Ratikantamishranordhausen/MectoSYS/09_Images/WhatsApp Image 2026-07-16 at 11.11.07 PM (3).jpeg

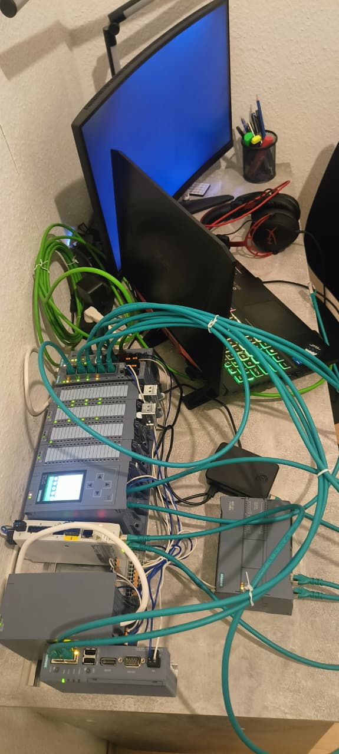
09_Images/WhatsApp Image 2026-07-16 at 11.11.07 PM (3).jpeg
