Ratikantamishranordhausen/MectoSYS/README.md

# MectoSYS
Secure Industry 4.0 OT/IT integration platform featuring real-time machine control, motion automation, industrial networking, edge computing, cloud connectivity, production data acquisition, cybersecurity, and remote maintenance.
