Ratikantamishranordhausen/MectoSYS/MectoSYS proto design.pdf

## MECTOSYS

### Machine Name

: MECTOSYS Prototype for software development, testing, validation and demo.

### Total Power Feed

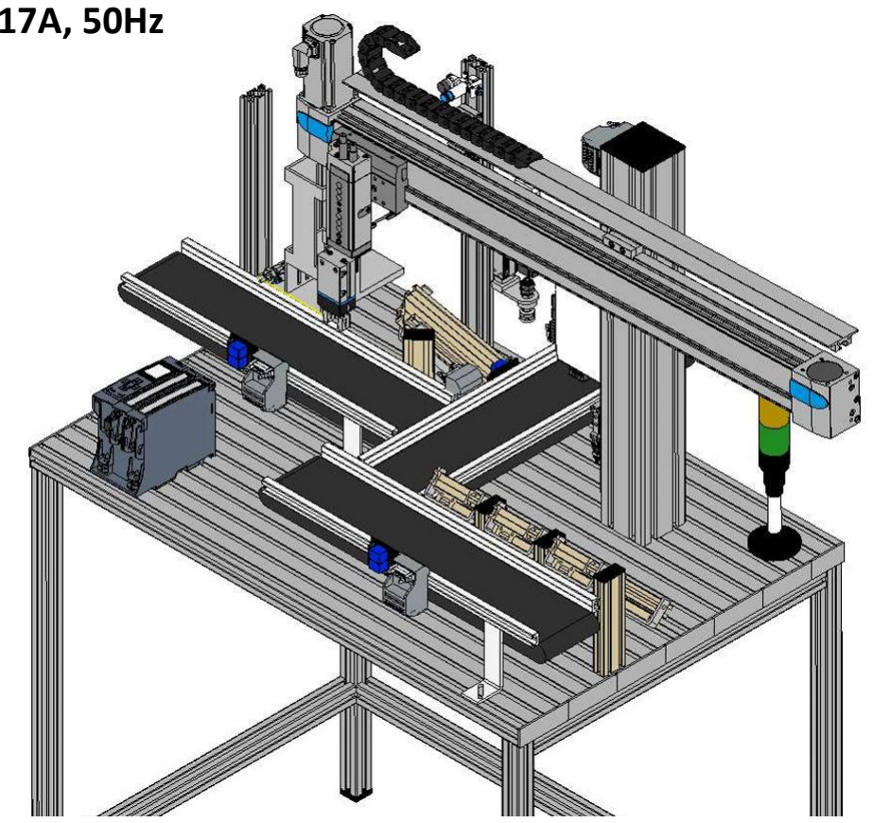
[picture p3: figure]

: | 1Φ, 4KVA, 230V AC, 17A, 50Hz

### Control Voltage

### : 24VDC Valve Voltage

### : 24VDC Voltage for Lamp

### : 24VDC

Volt.

### for Inputs

### : 24VDC Volt. for

### Output

### : 24VDC Drives

### : FESTO Make Drive Control

### : FESTO MAKE PLC

### : Siemens 1500/ 1200

## MECTOSYS

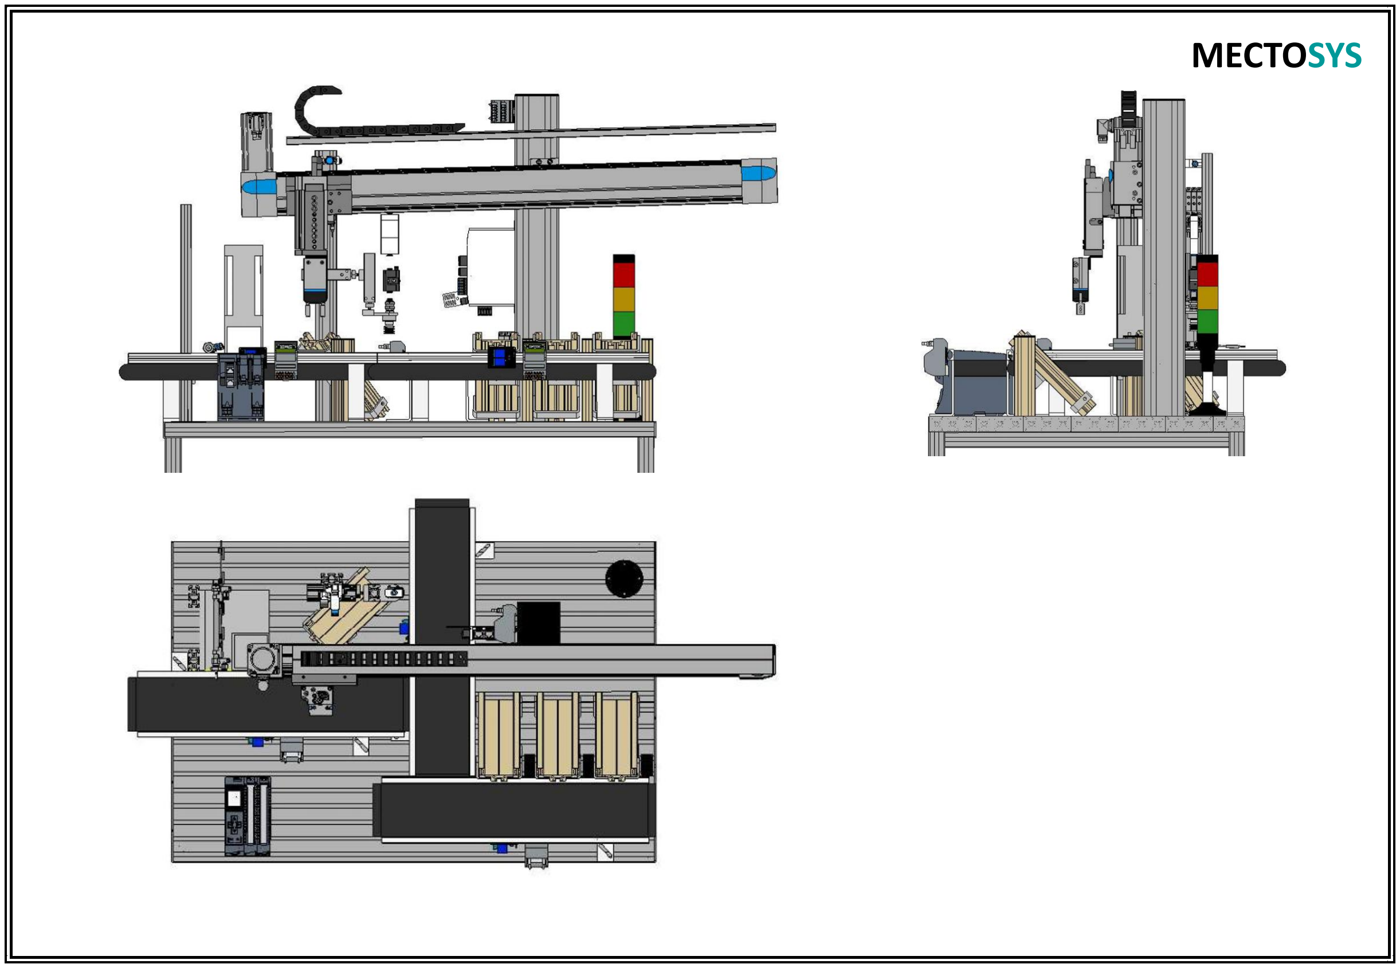
[picture p4: page 2]

### General Safety Instructions

- All installation, commissioning, and maintenance work must be carried out only by qualified and authorized personnel in accordance with applicable electrical standards and regulations.
- Before performing any work on the system, ensure that the power supply is completely disconnected and secured against accidental reconnection.
- Verify that all components are properly grounded and that protective earth connections are correctly installed.
- Use appropriate personal protective equipment (PPE) such as insulated gloves, safety shoes, and eye protection when working on electrical systems.
- Ensure that the supply voltage, frequency, and environmental conditions match the specifications of the installed devices.
- Do not exceed the rated current, voltage, or load capacity of any component to prevent overheating, damage, or fire hazards.
- Use correctly rated circuit protection devices (MCB, fuse, etc.) and ensure proper selection based on load characteristics.
- Avoid contact with live parts. Always assume that terminals are energized unless verified otherwise using appropriate measuring instruments.
- Ensure proper cable sizing, insulation, and routing to avoid mechanical damage, short circuits, or overheating.
- Maintain adequate ventilation around power supplies and electrical components to prevent overheating.
- Keep the work area clean and free from moisture, dust, and flammable materials.
- Do not modify or tamper with equipment unless explicitly permitted by the manufacturer.
- In case of abnormal operation (noise, smell, overheating), immediately disconnect the power supply and investigate the issue.
- Follow all manufacturer-specific guidelines for devices such as Siemens and FESTO components.
- Ensure emergency stop and isolation mechanisms are accessible and functioning correctly.

# PNEUMATIC CIRCUIT MECTOSYS

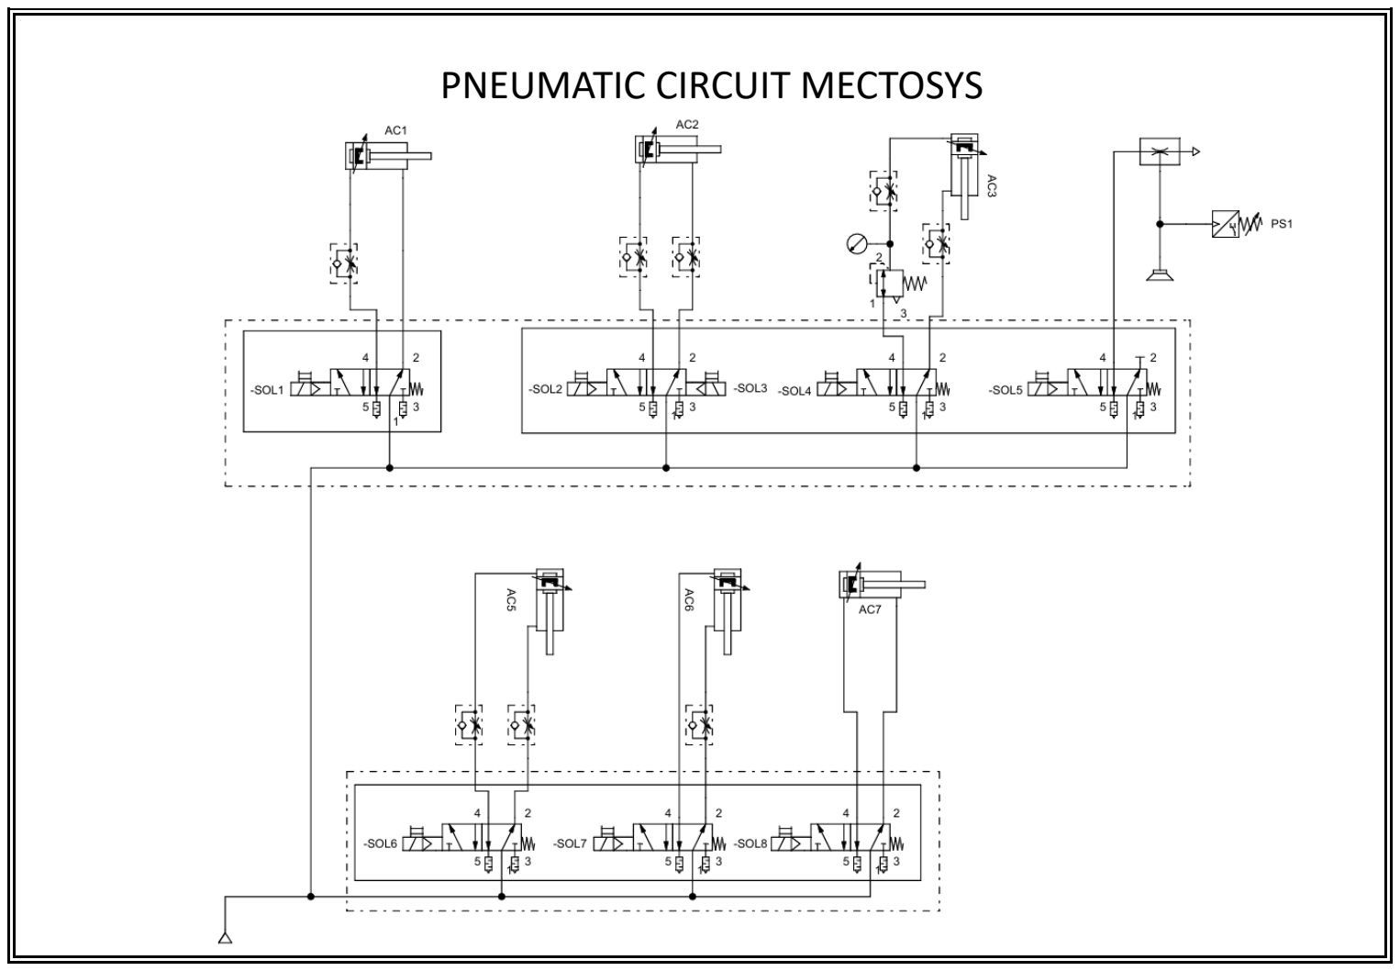
[picture p5: page 4]

X1
X4

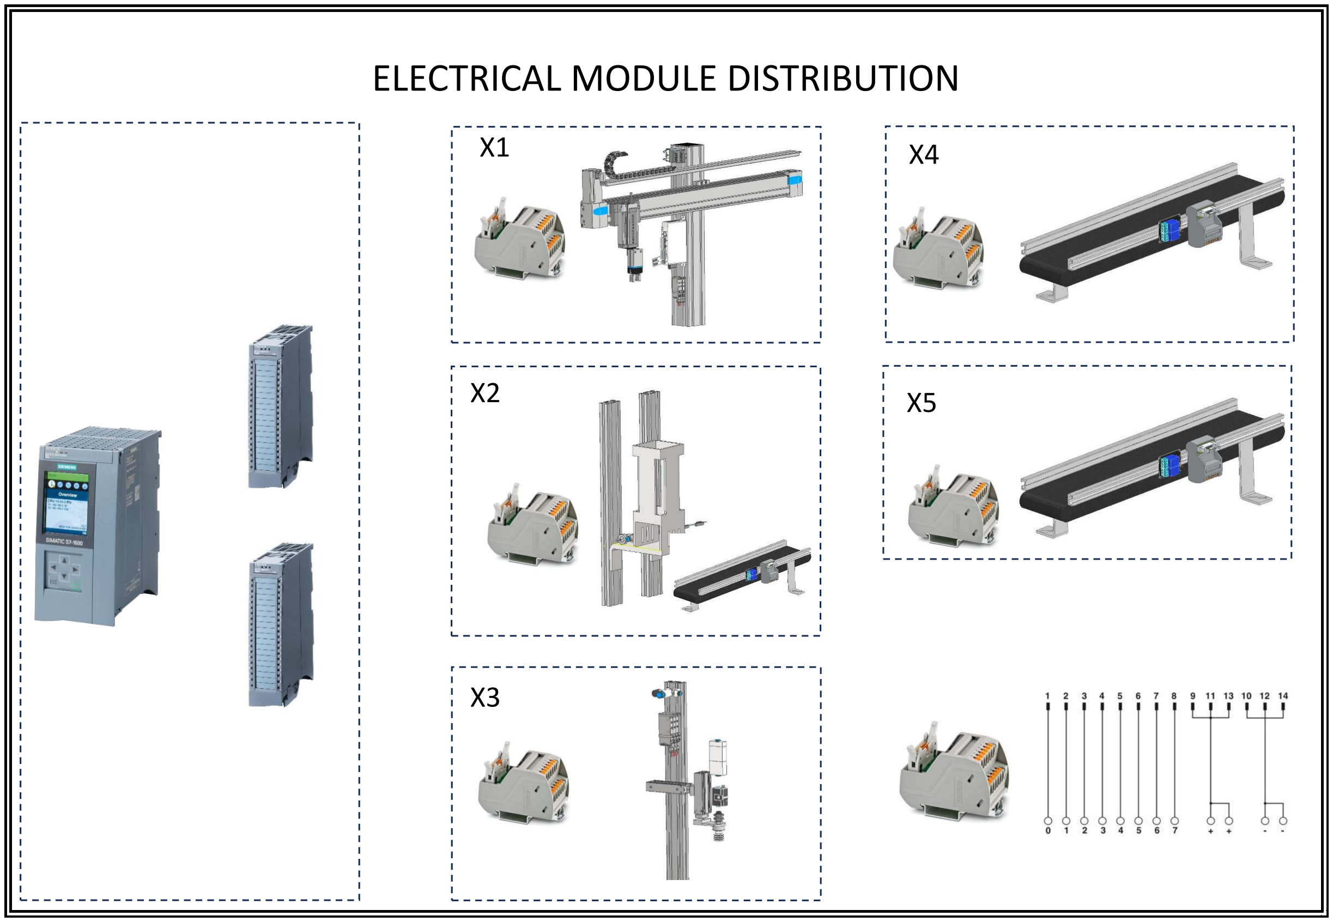
[picture p6: page 5]

X2

X3

X5

# ELECTRICAL MODULE DISTRIBUTION

OT Network Architecture OT Network Architecture (IT Network Confidential) (IT Network Confidential)

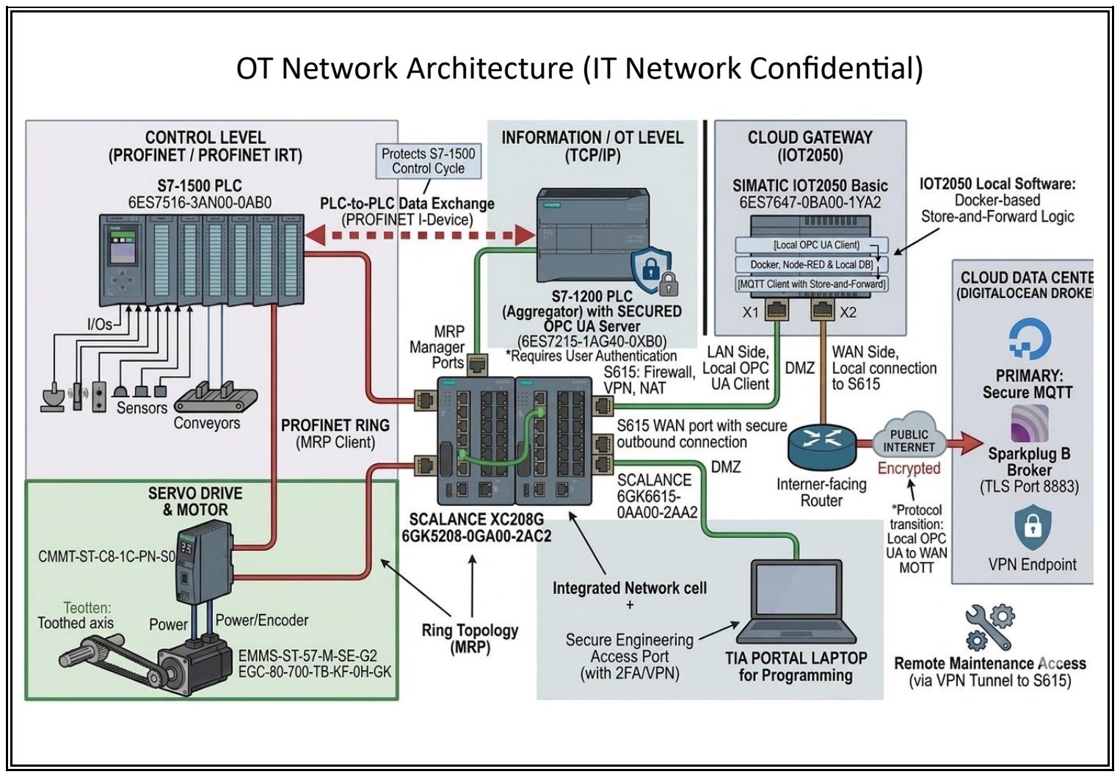
[picture p7: page 6]
