Ratikantamishranordhausen/MectoSYS/01_Mechanical_Design/01_CAD Design/PDF/conveyor.pdf

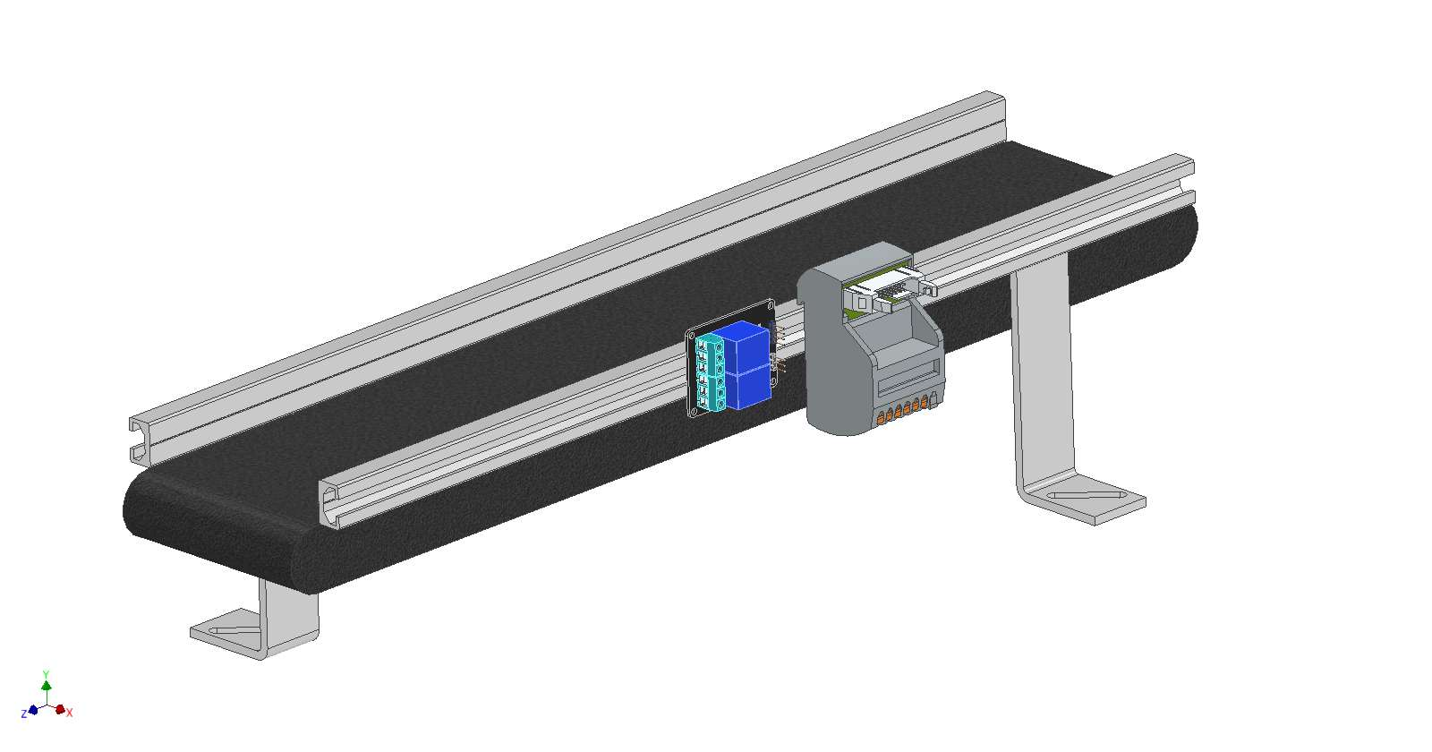
[picture p8: figure]
