Ratikantamishranordhausen/MectoSYS/01_Mechanical_Design/01_CAD Design/PDF/Distribution Module.pdf

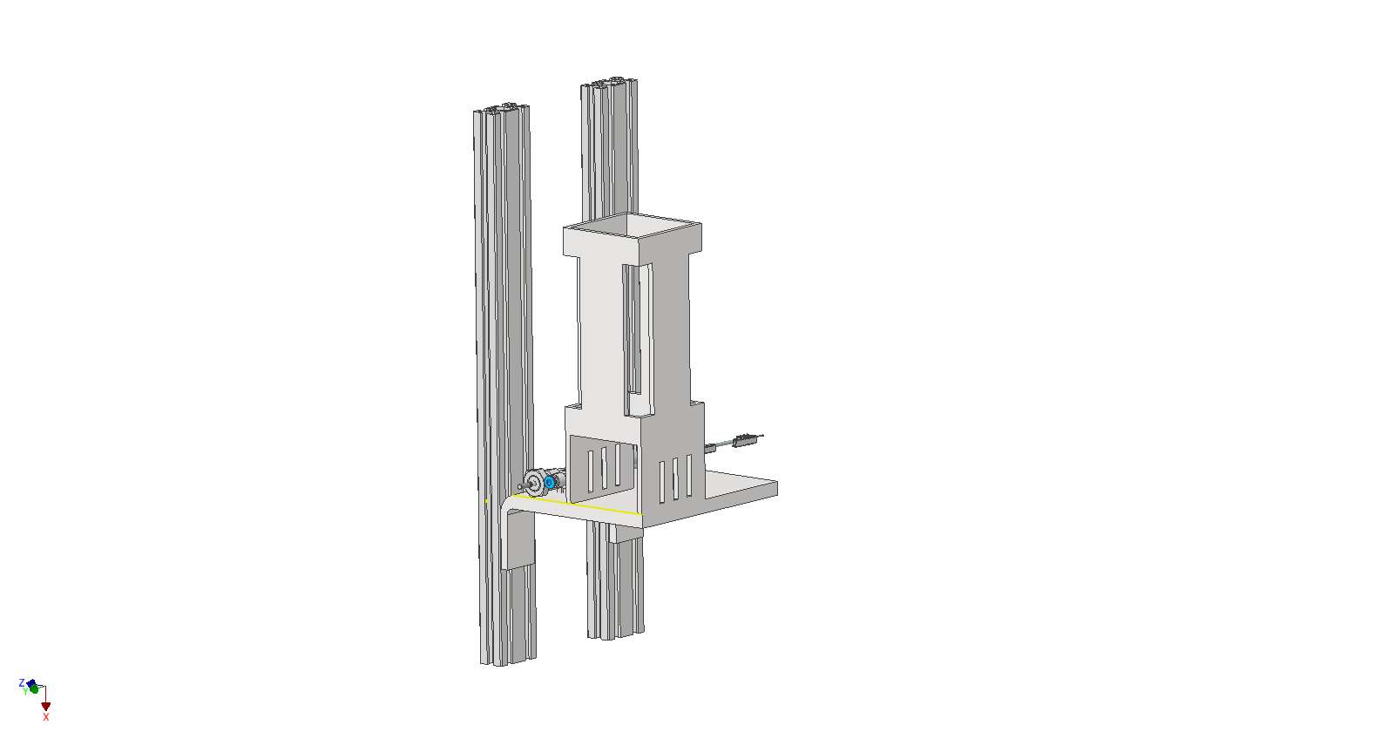
[picture p9: figure]
