Ratikantamishranordhausen/MectoSYS/01_Mechanical_Design/01_CAD Design/PDF/Handelling.pdf

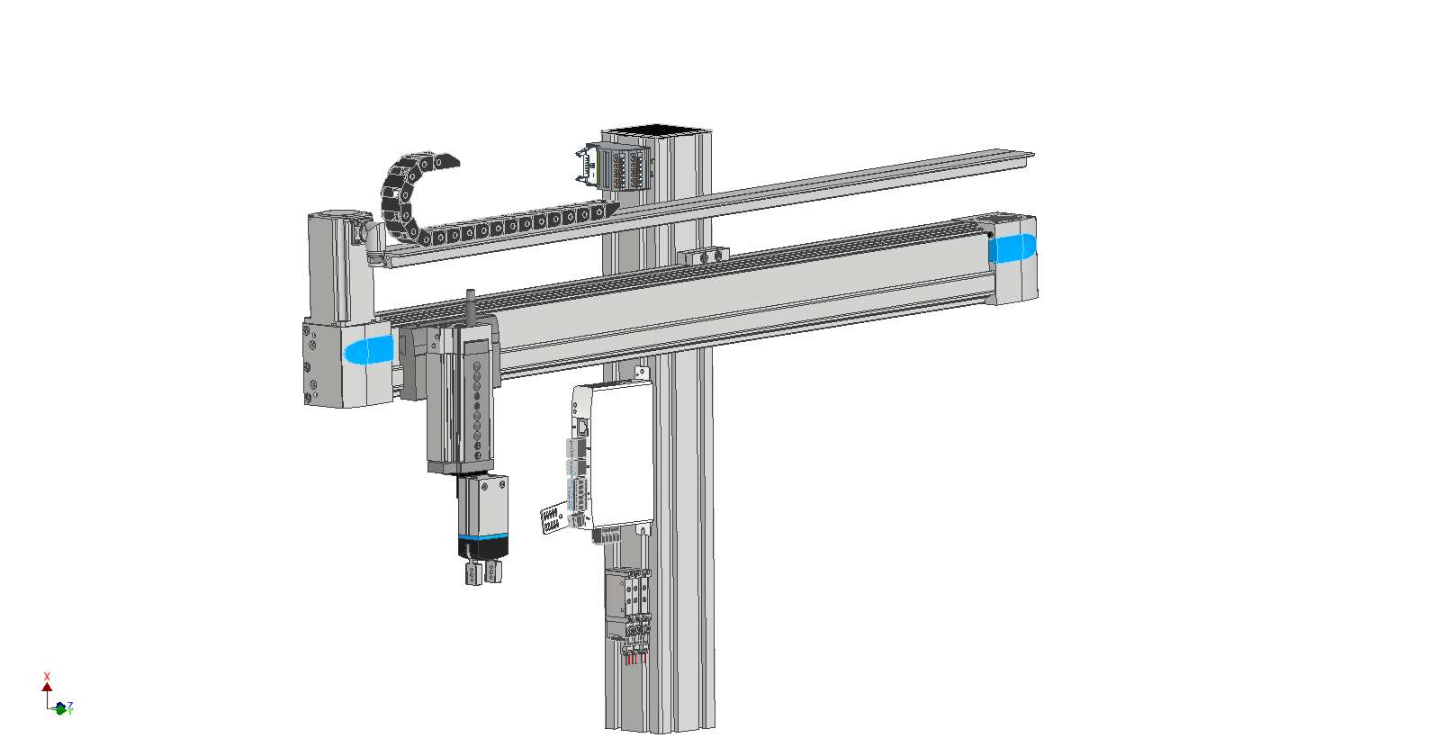
[picture p10: figure]
