Ratikantamishranordhausen/MectoSYS/01_Mechanical_Design/MectoSYS_Proto_BOM_Rev6.xlsx

Sr No | Component Name | Component Details | Part No | Criticality | Material Status | Remark | Supplier 1 |  |  |  |  |  |  |  | Supplier 2 |  |  |  |  |  |  |  | Supplier 3 |  |  |  |  |  |  |  | Supplier 4 |  |  |  |  |  |  |  | Lead Time (Days) | Specification
 |  |  |  |  |  |  | Supplier Name | Condition | Link | Price | Tax | Qty (Nos) | Total Price | Total Price | Supplier Name | Condition | Link | Price | Tax | Qty (Nos) | Total Price | Total Price | Supplier Name | Condition | Link | Price | Tax | Qty (Nos) | Total Price | Total Price | Supplier Name | Condition | Link | Price | Tax | Qty (Nos) | Total Price | Total Price
1 | Sick WTB4-3P2161 1028099 Photoelectric Sensor | Sensor | WTB4-3P2161 1028099 |  | Received |  | IndustryMall | Used | Link (https://industrymall.de/en/sensors/28370-sick-wtb4-3p2161-1028099-photoelectric-sensor.html) | 10.71 | 12.75 | 8 | 85.68 | 102.00 | Wiautomation | New | Link (https://de.wiautomation.com/sick/general-automation/sensors/WTB43P2161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) |  | 206 | 8 | 0 | 1648.00 | RS Components | New | Link (https://de.rs-online.com/web/p/optische-naherungsschalter/2409366?matchtype=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) |  | 212.74 | 8 |  | 1701.92
2 | Festo EMMS-ST-57-M-SE-G2 1370479 | Motor | EMMS-ST-57-M-SE-G2 1370479 | High | Received -OK |  | IndustryMall | Used | Link (https://industrymall.de/en/servo-engines/26403-festo-emms-st-57-m-se-g2-1370479.html) | 67.86 | 80.75 | 1 | 67.86 | 80.75 | RS Components | New | Link (https://de.rs-online.com/web/p/schrittmotoren/1816687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) | 427.96 | 509.27 | 1 | 427.96 | 509.27 | Landfeld | New | Link (https://www.landefeld.de/artikel/de/emms-st-57-m-se-g2-1370479-schrittmotor/OT-FESTO034681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) |  | 509.27 | 1 |  | 509.27 | Wiautomation | New | Link (https://de.wiautomation.com/festo/drives-motors-circuits-protection/1370479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) |  | 380 | 1 |  | 380
3 | Festo 8084004 CMMT-ST-C8-1C-PN-S0 Servo | Drive | CMMT-ST-C8-1C-PN-S0 8084004 | High | Received -OK |  | IndustryMall | Used | Link (https://industrymall.de/en/plc/26331-festo-8084004-cmmt-st-c8-1c-pn-s0-servo.html) | 125 | 148.75 | 1 | 125 | 148.75 | RS Components | New | Link (https://de.rs-online.com/web/p/motorsteuerungen/0193554?matchtype=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) | 466.20 | 554.78 | 1 | 466.2 | 554.78 | Landfeld | New | Link (https://www.landefeld.de/artikel/de/cmmt-st-c8-1c-pn-s0-8084004-servoantriebsregler/OT-FESTO085049) |  | 462.32 | 1 |  | 462.32 | Wiautomation | New | Link (https://de.wiautomation.com/festo/drives-motors-circuits-protection/8084004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) |  | 465 | 1 |  | 465
4 | Festo NEBM-M12W8-E-2.5-LE8 1451675 Encoder Cable New | Encoder cable | NEBM-M12W8-E-2.5-LE8 | HIgh | Received -OK |  | IndustryMall | Used | Link (https://industrymall.de/en/plc/29236-festo-nebm-m12w8-e-25-le8-1451675-encoder-cable-neu.html) | 25 | 29.75 | 1 | 25 | 29.75 | RS Components | New | Link (https://de.rs-online.com/web/p/sensor-und-aktor-kabel/2739632?searchId=2e5fe6e2-d660-4d90-86c9-56a42a7b367a) | 68.48 | 81.49 | 1 | 68.48 | 81.49 | Landfeld | New | Link (https://www.landefeld.de/artikel/de/nebm-m12w8-e-2-5-le8-1451675-encoderleitung/OT-FESTO035117) |  | 67.91 | 1 |  | 67.91 | Wiautomation | New | Link (https://de.wiautomation.com/festo/general-automation/1451675-festo-nebm-m12w8-e-2-5-le8) |  | 75.33 | 1 |  | 75.33
5 | Festo NEBM-S1W9-E-7-Q5-LE6 1450739 Motor cable | Motor cable | NEBM-S1W9-E-7-Q5-LE6 | High | Received -OK |  | IndustryMall | Used | Link (https://industrymall.de/en/plc/26931-festo-nebm-s1w9-e-7-q5-le6-1450739-motor-cable.html) | 17.86 | 21.25 | 1 | 17.86 | 21.25 | RS Components | New | Link (https://de.rs-online.com/web/p/motorzubehor/2739659?searchId=1fb4da12-3dd8-4de6-bb85-0255028b82dd) | 109.85 | 130.72 | 1 | 109.85 | 130.72 | Landfeld | New | Link (https://www.landefeld.de/artikel/de/nebm-s1w9-e-7-q5-le6-1450739-motorleitung/OT-FESTO035132) |  | 108.93 | 1 |  | 108.93 | Wiautomation | New | Link (https://de.wiautomation.com/festo/general-automation/1450945-festo-nebm-s1w15-e-5-q7-le6) |  | 99 | 1 |  | 99
6 | Festo EGC-80-700-TB-KF-0H-GK 556814 Toothed Belt Axis | Toothed Belt Axis | EGC-80-700-TB-KF-0H-GK 556814 | High | Received |  | IndustryMall | Used | Link (https://industrymall.de/en/hydraulics/27019-festo-egc-80-700-tb-kf-0h-gk-556814-toothed-belt-axis.html) | 114.29 | 136 | 1 | 114.29 | 136.00 | PTS | New | Link (https://www.pts-group.de/de/product/egc-70-800-tb-kf-0h-gk-zahnriemenachse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) | 1407.46 | 1674.88 | 1 | 1407.46 | 1674.88 | Landfeld | New | Link (https://www.landefeld.de/artikel/de/egc-80-600-tb-kf-0h-gk-3013355-zahnriemenachse/OT-FESTO058557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) |  | 1825.22 | 1 |  | 1825.22 | Wiautomation | New | Link (https://de.wiautomation.com/festo/general-automation/3012493-festo-egc-70-400-tb-kf-0h-gk?gad_source=1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) |  | 1143.82 | 1 |  | 1143.82
7 | Festo DHRS-25-A 1310162 Radial Gripper | Gripper | DHRS-25-A |  | Received |  | IndustryMall | Used | Link (https://industrymall.de/en/hydraulics/29671-festo-dhrs-25-a-1310162-radial-gripper.html) | 178.57 | 212.5 | 1 | 178.57 | 212.50 | Landefeld | New | Link (https://www.landefeld.de/artikel/de/dhrs-25-a-1310162-radialgreifer/OT-FESTO032839?campaign=GO_SH_Festo_DE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) |  | 652.57 | 1 | 0 | 652.57 | PTS | New | Link (https://www.pts-group.de/en/product/dhrs-25-a-radialgreifer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) |  | 548.38 | 1 |  | 548.38 |  |  |  |  |  |  |  | 0
8 | Festo DGSL-12-50-Y3A 543979 Mini Schlitten | Cylinder | DGSL-12-50-Y3A |  | Received |  | IndustryMall | Used | Link (https://industrymall.de/en/plc/26425-festo-dgsl-12-50-y3a-543979-mini-schlitten.html) | 89.29 | 106.25 | 1 | 89.29 | 106.25 | Landefeld | New | Link (https://www.landefeld.de/artikel/de/dgsl-12-50-y3a-543979-mini-schlitten/OT-FESTO025213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) |  | 996.24 | 1 | 0 | 996.24 | RS Components | New | Link (https://de.rs-online.com/web/p/pneumatik-fuhrungszylinder/2039377?matchtype=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) |  | 866.74 | 1 |  | 866.74 |  |  |  |  |  |  |  | 0
9 | Siemens 6GK5208-0GA00-2AC2 Scalance 6GK5 208-0GA00-2AC2 XC200G Ethernet Switch | Ethernet Switch | 6GK5208-0GA00-2AC2 | High | Received -OK |  | IndustryMall | Used | Link (https://industrymall.de/en/plc/26358-siemens-6gk5208-0ga00-2ac2-6gk5-208-0ga00-2ac2-scalance-xc200g-ethernet-switchneu.html) | 125 | 148.75 | 1 | 125 | 148.75 | RS Components | New | Link (https://de.rs-online.com/web/p/netzwerk-switches/2023795?searchId=90bcaddc-d525-4444-a14e-966afb5e181e) | 1104.94 | 1314.88 | 1 | 1104.94 | 1314.88 | Conrad | New | Link (https://www.conrad.de/de/p/siemens-6gk52080ga002ac2-6gk5208-0ga00-2ac2-industrial-ethernet-switch-2798206.html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) |  | 1485 | 1 |  | 1485.00 | Wiautomation | New | Link (https://de.wiautomation.com/siemens/industrial-communication/6GK52080GA002AC2) |  | 684.17 | 1 |  | 684.17
10 | Siemens 6EP3436-8SB00-0AY0 Sitop 6EP3 436-8SB00-0AY0 PSU8200 Power Supply | SMPS | 6EP3436-8SB00-0AY0 | HIgh | Received |  | IndustryMall | Used | Link (https://industrymall.de/en/plc/28996-siemens-6ep3436-8sb00-0ay0-sitop-6ep3-436-8sb00-0ay0-psu8200-power-supply.html) |  | 25.5 | 1 |  | 25.50 | RS Components | New | Link (https://de.rs-online.com/web/p/din-schienen-netzteile/1963645?searchId=987d6a84-deb3-471a-8b69-24683e5f3c1c) |  | 331.72 | 1 | 0 | 331.72 | Wiautomation | New | Link (https://de.wiautomation.com/siemens/power-supply/sitop/6EP34368SB000AY0) |  | 179.02 | 1 |  | 179.02 |  |  |  |  |  |  |  | 0
11 | 6ES7215-1AG40-0XB0 Siemens | PLC | 6ES7215-1AG40-0XB0 | HIgh | Received |  | Wiautomation | New | Link (https://de.wiautomation.com/siemens/plc-systems/simatic-s7/s7-1200/6ES72151AG400XB0) |  | 415.84 | 1 |  | 415.84 | RS Components | New | Link (https://de.rs-online.com/web/p/sps-zentralbaugruppen/8624487?searchId=facb9e98-01b1-4065-aea5-b98a99e11e23) | 708.94 | 843.64 | 1 | 708.94 | 843.64 | Conrad | New | Link (https://www.conrad.de/de/p/siemens-6es7215-1ag40-0xb0-6es72151ag400xb0-sps-kompakt-cpu-1737471.html?insert=NA) |  | 814.47 | 1 |  | 814.47 |  |  |  |  |  |  |  | 0
12 | Siemens 6ES76470BA001YA2 Simatic IOT2050 | Edge Gateway | 6ES7647-0BA00-1YA2 | HIgh | Received |  | Wiautomation | New | Link (https://de.wiautomation.com/siemens/industrial-communication/6es7647-0ba00-1ya2-siemens) |  | 475 | 1 |  | 475.00 | RS Components | New | Link (https://de.rs-online.com/web/p/iot-gateways/2017732?searchId=04151202-e713-4df3-8e39-8ed3ca6b7cfe) | 407.03 | 484.37 | 1 | 407.03 | 484.37 | Conrad | New | Link (https://www.conrad.de/de/p/siemens-6es76470ba001ya2-simatic-iot2050-quad-core-gateway-1-st-2269359.html) |  | 475 | 1 |  | 475.00 |  |  |  |  |  |  |  | 0
13 | 6GK5615-0AA00-2AA2 Siemens | Scalance S615 | 6GK5615-0AA00-2AA2 | High | Received |  | Wiautomation | New | Link (https://de.wiautomation.com/siemens/industrial-communication/6GK56150AA002AA2) |  | 545.01 | 1 |  | 545.01 | Conrad | New | Link (https://www.conrad.de/de/p/siemens-6gk5615-0aa00-2aa2-lan-router-10-100-mbit-s-1737956.html?hk=WW1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) |  | 643.73 | 1 |  | 643.73 | RS Components | New | Link (https://de.rs-online.com/web/p/router/1963680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) |  | 1458.57 | 1 |  | 1458.57
14 | 6 Series / slot width 8 / 300x30mm, Parallel Surfacing | Surface plate | EFSP6-30030-900 |  |  | Non-standard parts and different suppliers have different specifications; the specification details can be found in the specification column. So not possible to get 3 suppliers for the same part. | Misumi |  | Link (https://uk.misumi-ec.com/vona2/detail/110302689610/?PNSearch=EFSP6-30030-900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) | 142.74 | 169.86 | 2 | 285.48 | 339.72 |  |  |  |  |  |  |  | 0.00 |  |  |  |  |  |  |  | 0.00 |  |  |  |  |  |  |  |  | 11 | Overall Length L (mm) = 900
15 | 6 Series / slot width 8 / 30x30mm | 30X30 extrusion | HFS6-3030-2400 |  |  |  | Misumi |  | Link (https://uk.misumi-ec.com/vona2/detail/110302686450/?PNSearch=HFS6-3030-2400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) | 29.28 | 34.84 | 4 | 117.12 | 139.36 |  |  |  |  |  |  |  | 0.00 |  |  |  |  |  |  |  | 0.00 |  |  |  |  |  |  |  |  | 3 | Extrusion Type = HFS (Standard) | Surface Treatment = Clear Anodize | L Dimension Fixed, Specified = Configuration | Overall Length L (mm) = 2400
16 | 6 Series (Groove Width 8 mm), 1-Row Groove, Reversing Bracket With Protrusion | Connecting Bracket set | CHBLFSN6 |  |  |  | Misumi |  | Link (https://uk.misumi-ec.com/vona2/detail/110300442340/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) | 1.51 | 1.8 | 50 | 75.5 | 90.00 |  |  |  |  |  |  |  | 0.00 |  |  |  |  |  |  |  | 0.00 |  |  |  |  |  |  |  |  | 1 | Surface Treatment = Baked-on Finish (Silver) | Cover Mounting Hole Addition Work = Not Provided | Accessories = Not Provided
17 | Hexagon Socket Head Cap Screws | Screw | CBM6-12 |  |  |  | Misumi |  | Link (https://uk.misumi-ec.com/vona2/detail/110302261370/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) | 0.06 | 0.07 | 100 | 6.00 | 7.00 |  |  |  |  |  |  |  | 0.00 |  |  |  |  |  |  |  | 0.00 |  |  |  |  |  |  |  |  | 8 | Type = Hex Socket Head Cap Screw | Thread Dia. (mm) = 6 | Thread Length (mm) = 12 | Material = Steel | Surface Treatment = Bright Crome Plating
18 | 6 Series / Pre-Assembly Insertion Nuts【1 to 100 pieces】 | T Nut | PACK-HNTT6-6 |  |  |  | Misumi |  | Link (https://uk.misumi-ec.com/vona2/detail/110302610850/?PNSearch=PACK-HNTT6-6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) | 36.4 | 43.32 | 1 | 36.40 | 43.32 |  |  |  |  |  |  |  | 0.00 |  |  |  |  |  |  |  | 0.00 |  |  |  |  |  |  |  |  | 1 | Thread Nominal M (mm) = M6 | Material = Steel | Threadlocker = Not Provided | Sale Type = Bulk Packages
19 | Pads for Aluminium Extrusions | End cap | HFPD6-3030 |  |  |  | Misumi |  | Link (https://uk.misumi-ec.com/vona2/detail/110302266360/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) | 4.54 | 5.4 | 4 | 18.16 | 21.60 |  |  |  |  |  |  |  | 0.00 |  |  |  |  |  |  |  | 0.00 |  |  |  |  |  |  |  |  | 8 | Type = HFPD6-3030
20 | 6 Series / Frame End Caps | End cap | HFC6-3090-B |  |  |  | Misumi |  | Link (https://uk.misumi-ec.com/vona2/detail/110300446540/?PNSearch=HFC6-3090-B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) | 1.83 | 2.18 | 16 | 29.28 | 34.88 |  |  |  |  |  |  |  | 0.00 |  |  |  |  |  |  |  | 0.00 |  |  |  |  |  |  |  |  | 1 | Cap Shape = Rectangle | Extrusion Size = 3090 | Resin = Polyamide | Color = Black
21 | Slot Width 8mm / Flat Frame / No Flange / 1-Side Slot Type | Conveyor side bar | HFSPURE6-1220-2500 |  |  |  | Misumi |  | Link (https://uk.misumi-ec.com/vona2/detail/110302374430/?PNSearch=HFSPURE6-1220-2500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) | 32.5 | 38.68 | 2 | 65.00 | 77.36 |  |  |  |  |  |  |  | 0.00 |  |  |  |  |  |  |  | 0.00 |  |  |  |  |  |  |  |  | 10 | Extrusion Size: Width (mm) = 20 | Overall Length L (mm) = 2500
22 | Slot Width 8mm / Flat Aluminium Extrusions / With Shoulder | Slider | HFSFIN6-1554-1000 |  |  |  | Misumi |  | Link (https://uk.misumi-ec.com/vona2/detail/110302262430/?PNSearch=HFSFIN6-1554-1000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) | 38.1 | 45.34 | 2 | 76.20 | 90.68 |  |  |  |  |  |  |  | 0.00 |  |  |  |  |  |  |  | 0.00 |  |  |  |  |  |  |  |  | 9 | Extrusion Size: Width (mm) = 54 | Overall Length L (mm) = 1000
23 | 5 Series / slot width 6 / 20x40mm | Slider holder and pick and place | HFS5-2040-1500 |  |  |  | Misumi |  | Link (https://uk.misumi-ec.com/vona2/detail/110302684350/?PNSearch=HFS5-2040-1500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) | 21.6 | 25.7 | 2 | 43.20 | 51.40 |  |  |  |  |  |  |  | 0.00 |  |  |  |  |  |  |  | 0.00 |  |  |  |  |  |  |  |  | 3 | Surface Treatment = Clear Anodize | L Dimension Fixed, Specified = Configuration | Overall Length L (mm) = 1500
24 | 5 Series / Frame End Caps | End Cap | HFCL5-2040-B |  |  |  | Misumi |  | Link (https://uk.misumi-ec.com/vona2/detail/110300440510/?PNSearch=HFCL5-2040-B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) | 2.12 | 2.52 | 10 | 21.20 | 25.20 |  |  |  |  |  |  |  | 0.00 |  |  |  |  |  |  |  | 0.00 |  |  |  |  |  |  |  |  | 1 | Cap Shape = Rectangle | Extrusion Size = 2040 | Resin = Low-Density Polyethene | Color = Black
25 | Hexagon Socket Head Cap Screws | Screw | CBM5-8 |  |  |  | Misumi |  | Link (https://uk.misumi-ec.com/vona2/detail/110302261370/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) | 0.08 | 0.1 | 100 | 8 | 10.00 |  |  |  |  |  |  |  | 0.00 |  |  |  |  |  |  |  | 0.00 |  |  |  |  |  |  |  |  | 8 | Type = Hex Socket Head Cap Screw | Thread Dia. (mm) = 5 | Thread Length (mm) = 8 | Material = Steel | Surface Treatment = Bright Crome Plating
26 | 5 Series / Pre-Assembly Insertion Nuts【1 to 100 pieces】 | T Nut | HNTT5-5 |  |  |  | Misumi |  | Link (https://uk.misumi-ec.com/vona2/detail/110302607960/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) | 0.43 | 0.51 | 100 | 43 | 51.00 |  |  |  |  |  |  |  | 0.00 |  |  |  |  |  |  |  | 0.00 |  |  |  |  |  |  |  |  | 1 | Thread Nominal M (mm) = M5 | Material = Steel | Threadlocker = Not Provided | Sale Type = Single Item
27 | Din Rail | For terminal block mounting | NS35-7.5-1000 |  |  |  | Misumi |  | Link (https://uk.misumi-ec.com/vona2/detail/110500152830/?PNSearch=NS35-7.5-1000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) | 14.69 | 17.48 | 1 | 14.69 | 17.48 |  |  |  |  |  |  |  | 0.00 |  |  |  |  |  |  |  | 0.00 |  |  |  |  |  |  |  |  | 8 | Characteristics = Preferred Size Product | Size Width (mm) = 1000 | Sizes Vertical (mm) = 35 | Screw Size =M6 | Dimensions Thickness / Depth (mm) =7.5
28 | Round cylinder, DSNU Series | Cylinder | DSNU-8-100-P-A |  |  |  | Misumi |  | Link (https://uk.misumi-ec.com/vona2/detail/221302449625/?PNSearch=DSNU-8-100-P-A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) | 38 | 45.22 | 1 | 38 | 45.22 | Landefeld | New | Link (https://www.landefeld.de/artikel/de/dsnu-8-100-p-a-19182-normzylinder/OT-FESTO000997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) |  | 47.43 | 1 |  | 47.43 | RS Components | New | Link (https://de.rs-online.com/web/p/pneumatische-kolbenzylinder/2021730?matchtype=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) |  | 47.43 | 1 |  | 47.43 |  |  |  |  |  |  |  |  | 3 | Stroke: L (mm) = 100 | Piston diameter (mm) = 8 | Pneumatic connection = M5 | Piston rod thread = M4
29 | Proximity sensor, SMT Series | Read switch | SMT-8M-A-PS-24V-E-2.5-OE |  |  |  | Misumi |  | Link (https://uk.misumi-ec.com/vona2/detail/221302447971/?PNSearch=SMT-8M-A-PS-24V-E-2.5-OE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) | 30.4 | 32.75 | 2 | 60.8 | 65.50 | Landefeld | New | Link (https://www.landefeld.de/artikel/de/smt-8m-a-ps-24v-e-25-oe-574335-naeherungsschalter/OT-FESTO032898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) |  | 36.87 | 2 |  | 73.74 | RS Components | New | Link (https://de.rs-online.com/web/p/pneumatische-zylindersensoren/1215836?matchtype=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) |  | 39.53 | 2 |  | 79.06 |  |  |  |  |  |  |  |  | 3 | Design = for T-Slot | DC operating voltage range (V) = 5-30 | Switching output = PNP | Cable length (m) = 2.5
30 | Mounting kit, SMBR Series | Read switch mounting bracket | SMBR-8-8 |  |  |  | Misumi |  | Link (https://uk.misumi-ec.com/vona2/detail/221302445913/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) | 5 | 5.95 | 2 | 10 | 11.90 | Landefeld | New | Link (https://www.landefeld.de/artikel/de/smbr-8-8-175091-befestigungsbausatz/OT-FESTO001422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) |  | 6.5 | 2 |  | 13.00 | RS Components | New | Link (https://de.rs-online.com/web/p/pneumatisches-zylinder-und-antriebszubehor/1754591?matchtype=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) |  | 6.5 | 2 |  | 13.00 |  |  |  |  |  |  |  |  | 3 | Size = 8
31 | One-way flow control valve, GRLA Series | Flow control valve | GRLA-M5-QS-4-D |  |  |  | Misumi |  | Link (https://uk.misumi-ec.com/vona2/detail/221302434371/?PNSearch=GRLA-M5-QS-4-D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) | 14.8 | 17.61 | 4 | 59.2 | 70.44 | Landefeld | New | Link (https://www.landefeld.de/artikel/de/grla-m5-qs-4-d-193138-drossel-rueckschlagventil/OT-FESTO011856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) |  | 19.44 | 4 |  | 77.76 | RS Components | New | Link (https://de.rs-online.com/web/p/pneumatische-funktionsanschlusse/1214355?matchtype=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) |  | 19.44 | 4 |  | 77.76 |  |  |  |  |  |  |  |  | 3 | Seals material = NBR | Pneumatic connection 1 = Qs-4 | Pneumatic connection 2 = M5
32 | Push-in fitting, QSM Series | Push in fitting | QSM-M5-4 |  |  |  | Misumi |  | Link (https://uk.misumi-ec.com/vona2/detail/221302439185/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) | 2.1 | 2.5 | 27 | 56.7 | 67.50 | Landefeld | New | Link (https://www.landefeld.de/artikel/de/qsm-m5-4-153304-steckverschraubung/OT-FESTO015368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) |  | 3.02 | 27 |  | 81.54 | RS Components | New | Link (https://de.rs-online.com/web/p/pneumatische-anschlusse/2023356?matchtype=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) |  | 30.82 | 3 |  | 92.46 |  |  |  |  |  |  |  |  | 3 | Pneumatic connection 1 = External thread M5 | Pneumatic connection 2 = for 4mm tube | Pack size = 10
33 | Pneumatic muffler, AMTE Series | Silencer | AMTE-M-LH-M5 |  |  |  | Misumi |  | Link (https://uk.misumi-ec.com/vona2/detail/221302435934/?PNSearch=AMTE-M-LH-M5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) | 2.3 | 2.74 | 20 | 46 | 54.80 | Landefeld | New | Link (https://www.landefeld.de/artikel/de/amte-m-lh-m5-1205858-schalldaempfer/OT-FESTO040788) |  | 2.88 | 15 |  | 43.20 | RS Components | New | Link (https://de.rs-online.com/web/p/pneumatischer-schalldampfer/1216001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) |  | 57.6 | 1 |  | 57.60 |  |  |  |  |  |  |  |  | 3 | Pneumatic connection = M5 | Pack size = 20 | Flow rate with respect to atmosphere (l/min) = 225
34 | Plastic tubing, PUN Series【1 to 500 pieces】 | Tube | PUN-H-4X0.75-NT |  |  |  | Misumi |  | Link (https://uk.misumi-ec.com/vona2/detail/221302434090/?PNSearch=PUN-H-4X0.75-NT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) | 0.7 | 0.83 | 50 | 35 | 41.50 | Landefeld | New | Link (https://www.landefeld.de/artikel/de/pun-h-4x075-nt-197376-kunststoffschlauch/OT-FESTO014713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) |  | 0.92 | 50 |  | 46.00 | RS Components | New | Link (https://de.rs-online.com/web/p/druckluftrohre/1262775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) |  | 45.82 | 1 |  | 45.82 |  |  |  |  |  |  |  |  | 3 | Outer Diameter D (Ø) = 4 | Inner Diameter d (Ø) = 2.6 | Product type = Hydrolysis-resistance
35 | Plastic tubing, PUN Series【1 to 500 pieces】 | Tube Blue | PUN-H-4X0.75-BL |  |  |  | Misumi |  | Link (https://uk.misumi-ec.com/vona2/detail/221302434090/?PNSearch=PUN-H-4X0.75-BL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) | 0.7 | 0.83 | 50 | 35 | 41.50 | Landefeld | New | Link (https://www.landefeld.de/artikel/de/pun-h-4x075-bl-197383-kunststoffschlauch/OT-FESTO014711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..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) |  | 0.92 | 50 |  | 46.00 | RS Components | New | Link (https://de.rs-online.com/web/p/druckluftrohre/1216290?searchId=a3f33804-e9bd-4c36-9b39-e28d174dc3f6) |  | 45.82 | 1 |  | 45.82
36 | Plastic tubing, PUN Series【1 to 500 pieces】 | Tube Black | PUN-H-4X0.75-SW |  |  |  | Misumi |  | Link (https://uk.misumi-ec.com/vona2/detail/221302434090/?PNSearch=PUN-H-4X0.75-SW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) | 0.7 | 0.83 | 50 | 35 | 41.50 | Landefeld | New | Link (https://www.landefeld.de/artikel/de/pun-h-4x075-sw-197390-kunststoffschlauch/OT-FESTO014714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..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) |  | 0.92 | 50 |  | 46.00 | RS Components | New | Link (https://de.rs-online.com/web/p/druckluftrohre/1216392?searchId=afad0f8d-e49e-46ea-97d4-b1b63b37dc17) |  | 45.82 | 1 |  | 45.82
37 | Multiple distributor, QSQ Series | Distributer 4 mm | QSQ-6-4 |  |  |  | Misumi |  | Link (https://uk.misumi-ec.com/vona2/detail/221302438410/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) | 6.5 | 7.74 | 3 | 19.5 | 23.22 | Landefeld | New | Link (https://www.landefeld.de/artikel/de/qsq-6-4-153209-mehrfachverteiler/OT-FESTO015465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) |  | 9.09 | 3 |  | 27.27 | RS Components | New | Link (https://de.rs-online.com/web/p/pneumatische-anschlusse/2024298?matchtype=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) |  | 9.09 | 3 |  | 27.27
38 | 8 Series / Post-Assembly Insertion Nuts | M6 8 series | HNTF8-6 |  |  | Non-standard parts and different suppliers have different specifications; the specification details can be found in the specification column. So not possible to get 3 suppliers for the same part. | Misumi |  | Link (https://uk.misumi-ec.com/vona2/detail/110302615750/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) | 0.67 | 0.8 | 20 | 13.4 | 16.00 |  |  |  |  |  |  |  | 0.00 |  |  |  |  |  |  |  | 0.00
39 | Hexagon Socket Head Cap Screws | M6-14 | CBM6-14 |  |  |  | Misumi |  | Link (https://uk.misumi-ec.com/vona2/detail/110302261370/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) | 0.32 | 0.38 | 20 | 6.4 | 7.60 |  |  |  |  |  |  |  | 0.00 |  |  |  |  |  |  |  | 0.00
40 | 8 Series / slot width 10 / 80x80mm | Extrusion | HFS8-8080-1000 |  |  |  | Misumi |  | Link (https://uk.misumi-ec.com/vona2/detail/110302690740/?HissuCode=HFS8-8080-1000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) | 69.8 | 83.06 | 1 | 69.8 | 83.06 |  |  |  |  |  |  |  | 0.00 |  |  |  |  |  |  |  | 0.00 |  |  |  |  |  |  |  |  | 3
41 | 8 Series / Frame End Caps | End Cap | HFC8-8080-B |  |  |  | Misumi |  | Link (https://uk.misumi-ec.com/vona2/detail/110300452840/?PNSearch=HFC8-8080-B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) | 4.23 | 5.03 | 2 | 8.46 | 10.06 |  |  |  |  |  |  |  | 0.00 |  |  |  |  |  |  |  | 0.00
42 | 5 Series / Post-Assembly Insertion Spring Nuts | Post assembly nut | HNTP5-4 |  |  |  | Misumi |  | Link (https://uk.misumi-ec.com/vona2/detail/110302608410/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) | 0.6 | 0.71 | 40 | 24 | 28.40 |  |  |  |  |  |  |  | 0.00 |  |  |  |  |  |  |  | 0.00
43 | 8 Series / Post-Assembly Insertion Nuts | M4 8 series | HNTF8-4 |  |  |  | Misumi |  | Link (https://uk.misumi-ec.com/vona2/detail/110302615750/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) | 0.67 | 0.8 | 20 | 13.4 | 16.00 |  |  |  |  |  |  |  | 0.00 |  |  |  |  |  |  |  | 0.00
44 | Hex Socket Head Bolt | M4-8 | CSS-04-08 |  |  |  | Misumi |  | Link (https://uk.misumi-ec.com/vona2/detail/221005479774/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) | 1.65 | 1.96 | 10 | 16.5 | 19.60 |  |  |  |  |  |  |  | 0.00 |  |  |  |  |  |  |  | 0.00
45 | Hexagon Socket Head Cap Screws Flat / Steel, Stainless Steel | M3-10 | HFBCM3-10 |  |  |  | Misumi |  | Link (https://uk.misumi-ec.com/vona2/detail/110300463610/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) | 0.33 | 0.39 | 10 | 3.3 | 3.90 |  |  |  |  |  |  |  | 0.00 |  |  |  |  |  |  |  | 0.00
46 | Conveyor Sensor Brackets / Post-Assembly Insertion Nuts For Sensors |  | BFCBN40-6 |  |  |  | Misumi |  | Link (https://uk.misumi-ec.com/vona2/detail/110302536310/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) | 5.04 | 6 | 10 | 50.4 | 60.00 |  |  |  |  |  |  |  | 0.00 |  |  |  |  |  |  |  | 0.00
47 | 5 Series / Post-Assembly Insertion Spring Nuts | M3 | HNTP5-3 |  |  |  | Misumi |  | Link (https://uk.misumi-ec.com/vona2/detail/110302608410/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) | 0.6 | 0.71 | 20 |  | 14.20 |  |  |  |  |  |  |  | 0.00 |  |  |  |  |  |  |  | 0.00
48 | 8 Series / Post-Assembly Insertion Short Nuts【1 to 100 pieces】 | M3 | HNTAJ8-3 |  |  |  | Misumi |  | Link (https://uk.misumi-ec.com/vona2/detail/110302616720/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) | 0.68 | 0.81 | 20 |  | 16.20 |  |  |  |  |  |  |  | 0.00 |  |  |  |  |  |  |  | 0.00
49 | 8 Series / Post-Assembly Insertion Spring Nuts | M5 | HNTP8-5 |  |  |  | Misumi |  | Link (https://uk.misumi-ec.com/vona2/detail/110302616360/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) | 0.68 | 0.81 | 20 |  | 16.20 |  |  |  |  |  |  |  | 0.00 |  |  |  |  |  |  |  | 0.00
50 | Hexagon Socket Head Cap Screws | M3x35 | CBM3-35 |  |  |  | Misumi |  | Link (https://uk.misumi-ec.com/vona2/detail/110302261370/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) | 0.38 | 0.45 | 20 |  | 9.00 |  |  |  |  |  |  |  | 0.00 |  |  |  |  |  |  |  | 0.00
51 | Hexagon Socket Head Cap Screws | M4x22 | CBM4-22 |  |  |  | Misumi |  | Link (https://uk.misumi-ec.com/vona2/detail/110302261370/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) | 0.29 | 0.35 | 40 |  | 14.00 |  |  |  |  |  |  |  | 0.00 |  |  |  |  |  |  |  | 0.00
52 | Hexagon Socket Head Cap Screws | M5x18 | CBM5-18 |  |  |  | Misumi |  | Link (https://uk.misumi-ec.com/vona2/detail/110302261370/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) | 0.29 | 0.35 | 40 |  | 14.00 |  |  |  |  |  |  |  | 0.00 |  |  |  |  |  |  |  | 0.00
53 | Hexagon Socket Head Cap Screws | M6x30 | CBM6-30 |  |  |  | Misumi |  | Link (https://uk.misumi-ec.com/vona2/detail/110302261370/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) | 0.15 | 0.18 | 40 |  | 7.20 |  |  |  |  |  |  |  | 0.00 |  |  |  |  |  |  |  | 0.00
54 | 5 Series / Angular 45 / 135 degree Angle / 2 Slots | Angle bracket | HBL45TD5 |  |  |  | Misumi |  | Link (https://uk.misumi-ec.com/vona2/detail/110300439270/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) | 3.97 | 4.72 | 6 |  | 28.32 |  |  |  |  |  |  |  | 0.00 |  |  |  |  |  |  |  | 0.00
55 | Wiring Duct (with Upper Slit / Low Cost) |  | MD-1.5L-R |  |  |  | Misumi |  | Link (https://uk.misumi-ec.com/vona2/detail/110400152740/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) | 11.76 | 13.99 | 1 |  | 13.99 |  |  |  |  |  |  |  | 0.00 |  |  |  |  |  |  |  | 0.00
56 | Air solenoid valve, VUVG Series | Valve | VUVG-L10-M52-MT-M5-1H2L-W1 |  |  |  | Misumi |  | Link (https://uk.misumi-ec.com/vona2/detail/221302444518/?HissuCode=VUVG-L10-M52-MT-M5-1H2L-W1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) | 63.6 | 75.68 | 4 | 254.4 | 302.72 | Landefeld | New | Link (https://www.landefeld.de/artikel/de/vuvg-l10-m52-mt-m5-1h2l-w1-578162-magnetventil/OT-FESTO040715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) |  | 89.55 | 4 |  | 358.20 | RS Components | New | Link (https://de.rs-online.com/web/p/pneumatik-regelventile-magnetvorgesteuert/1816402?matchtype=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) |  | 89.55 | 4 |  | 358.20 |  |  |  |  |  |  |  |  | 4
57 | MUE-70/80 (558043) Profile mounting | Profile Mounting | MUE-70/80 (558043) |  | Received |  | Landefeld |  | Link (https://www.landefeld.de/artikel/de/mue-7080-558043-profilbefestigung/OT-FESTO028207) |  | 40.98 | 1 | 0 | 40.98 | Digikey | New | Link (https://www.digikey.de/de/products/detail/festo-corporation/MUE-70-80/19232660?gclsrc=aw.ds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) |  | 43.54 | 1 |  | 43.54 | RS Components | New | Link (https://de.rs-online.com/web/p/pneumatisches-zylinder-und-antriebszubehor/0652034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) |  | 40.98 | 1 |  | 40.98
58 | NEBA-M8G3-U-2.5-N-LE3 (8078223) Connecting cable | Connecting cable | NEBA-M8G3-U-2.5-N-LE3 (8078223) |  | Received |  | Landefeld |  | Link (https://www.landefeld.de/artikel/de/neba-m8g3-u-2-5-n-le3-8078223-verbindungsleitung/OT-FESTO096751) |  | 9.57 | 5 | 0 | 47.85 | RS Components | New | Link (https://de.rs-online.com/web/p/sensor-und-aktor-kabel/0362555?matchtype=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) |  | 9.57 | 5 |  | 47.85 | SP spare part | New | Link (https://www.google.com/search?q=NEBA-M8G3-U-2.5-N-LE3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) |  | 10.61 | 5 |  | 53.05
59 | QS-G1/4-8-50 (132040) Push-in fitting |  | QS-G1/4-8-50 |  | Received |  | Landefeld |  | Link (https://www.landefeld.de/artikel/de/qs-g14-8-50-132040-steckverschraubung/OT-FESTO024341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) |  | 2.42 | 2 | 0 | 4.84 | Druckluft | New | Link (https://www.druckluft-fachhandel.de/festo-qs-g1-4-8-50-132040-steckverschraubung) |  | 2.42 | 2 |  | 4.84 | Kinetik | New | Link (https://kinetikmsystem.de/en/festo/connection-technology/pneumatic-connection-technology/push-in-fitting-qs/7528/qs-g1/4-8-50-132040-festo-push-in-fitting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) |  | 2.42 | 2 |  | 4.84 | Conrad | New | Link (https://www.conrad.de/de/p/festo-steckverschraubung-132040-qs-g1-4-8-50-1-st-1896380.html) |  | 2.03 | 2 |  | 4.06
60 | PUN-H-6X1-BL (197384) Plastic hose | 6 mm tube | PUN-H-6X1-BL |  | Received |  | Landefeld |  | Link (https://www.landefeld.de/artikel/de/pun-h-6x1-bl-197384-kunststoffschlauch/OT-FESTO014715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) |  | 1.33 | 20 | 0 | 26.60 | Conrad | New | Link (https://www.conrad.de/de/p/norgren-druckluftschlauch-pu2-0506025c-polyurethan-blau-innen-durchmesser-4-mm-9-bar-meterware-582925.html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) |  | 1.79 | 20 |  | 35.80 | RS Components | New | Link (https://de.rs-online.com/web/p/druckluftrohre/1216292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) |  | 66.64 | 1 |  | 66.64
61 | QSC-4H-100 (130699) blind plug |  | QSC-4H-100 |  | Received |  | Landefeld |  | Link (https://www.landefeld.de/artikel/de/qsc-4h-100-130699-blindstopfen/OT-FESTO020038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) |  | 1.05 | 6 | 0 | 6.30 | Conrad | New | Link (https://www.conrad.de/de/p/festo-qsc-4h-100-130699-reduzierverbindung-1-st-1894471.html) |  | 1.05 | 6 |  | 6.30 | Kinetik | New | Link (https://kinetikmsystem.de/en/festo/connection-technology/pneumatic-connection-technology/push-in-fitting-qsc/8184/qsc-4h-100-130699-festo-blanking-plug) |  | 1.05 | 6 |  | 6.30
62 | QSC-6H-100 (130700) blind plug |  | QSC-6H-100 |  | Received |  | Landefeld |  | Link (https://www.landefeld.de/artikel/de/qsc-6h-100-130700-blindstopfen/OT-FESTO020040) |  | 1.05 | 6 | 0 | 6.30 | Druckluft | New | Link (https://www.druckluft-fachhandel.de/festo-qsc-6h-100-130700-blindstopfen) |  | 1.05 | 6 |  | 6.30 | Kinetik | New | Link (https://kinetikmsystem.de/en/festo/connection-technology/pneumatic-connection-technology/push-in-fitting-qsc/8186/qsc-6h-100-130700-festo-blanking-plug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) |  | 1.05 | 6 |  | 6.30 | Conrad | New | Link (https://www.conrad.de/de/p/festo-qsc-6h-100-130700-reduzierverbindung-1-st-1894472.html?insert=NA) |  | 0.88 | 6 |  | 5.28
63 | TK-3 SMC hose cutter |  | OT-SMC064162 |  | Received |  | Landefeld |  | Link (https://www.landefeld.de/artikel/de/tk-3-smc-schlauchschneider/OT-SMC064162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) |  | 10.14 | 1 | 0 | 10.14 | RS Components | New | Link (https://de.rs-online.com/web/p/rohrschneider/6679400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) |  | 10.65 | 1 |  | 10.65 | Rubix | New | Link (https://uk.rubix.com/en/tk-series-tube-cutters/p-G1324040910) |  | 10.16 | 1 |  | 10.16
64 | Signal light, red/yellow/green, LED, 24 V AC/DC | Tower lamp | HBJD-D3RYG24B |  | Received | Supplier not available for the same part no. | reichelt |  | Link (https://www.reichelt.de/de/de/shop/produkt/signalampel_rot_gelb_gruen_led_24_v_ac_dc-406312?PROVID=2788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) |  | 27.2 | 1 | 0 | 27.20 |  |  |  |  |  |  | 0 | 0.00 |  |  |  |  |  |  |  | 0.00 |  |  |  |  |  |  |  | 0
65 | Pushbutton, 1 normally open contact, momentary | Push button green | XB5AA31 |  | Received |  | reichelt |  | Link (https://www.reichelt.de/de/de/shop/produkt/drucktaster_1_schliesser_tastend-221698?PROVID=2788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) |  | 10.5 | 2 | 0 | 21.00 | Conrad | New | Link (https://www.conrad.de/de/p/schneider-electric-xb5aa31c0-kleinverteilerzubehoer-1-st-2933403.html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) |  | 11.99 | 2 | 0 | 23.98 | RS Components | New | Link (https://de.rs-online.com/web/p/drucktaster-schalter/6096007?searchId=3433e9fb-2f70-41f1-b3a2-1bd871d98d48) |  | 16.61 | 2 |  | 33.22 |  |  |  |  |  |  |  | 0
66 | Push button, 1 normally open contact, momentary | Push button red | XB4BA42 |  | Received |  | reichelt |  | Link (https://www.reichelt.de/de/de/shop/produkt/drucktaster_1_effner_tastend-221687?PROVID=2788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) |  | 14.7 | 1 | 0 | 14.70 | Conrad | New | Link (https://www.conrad.de/de/p/schneider-electric-xb4ba42-harmony-xb4ba42-drucktaster-betaetiger-flach-1-taste-rot-druckentriegelung-1-st-445049.html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) |  | 17.99 | 1 | 0 | 17.99 | RS Components | New | Link (https://de.rs-online.com/web/p/drucktaster-schalter/3308644?matchtype=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) |  | 20.25 | 1 |  | 20.25 |  |  |  |  |  |  |  | 0
73 | Selector switch, 22 mm, 2 positions, latching, 2 normally open contacts | selector switch | XB5AD23 |  |  |  | reichelt | 1 | Link (https://www.reichelt.de/de/de/shop/produkt/wahlschalter_22_mm_2_stellungen_rastend_2_schliesser-340232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) |  | 25.3 | 1 | 0 | 25.30 | Conrad | New | Link (https://www.conrad.de/de/p/schneider-electric-xb5ad23-xb5ad23-wahlschalter-ip67-1-st-1982582.html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) |  | 27.90 | 1 | 0 | 27.90 | RS Components | New | Link (https://de.rs-online.com/web/p/wahlschalter/0212043?searchId=29a3ccd6-6f6b-4f3b-b1c6-d07f7eecf70c) |  | 32.03 | 1 |  | 32.03 |  |  |  |  |  |  |  | 0
67 | Aufbaugehäuse, Not-Halt / Not-Aus, 1 Schließer/1 Öffner für Ø 22 | Emergency switch | XALK178E |  | Received |  | reichelt |  | Link (https://www.reichelt.de/de/de/shop/produkt/aufbaugehaeuse_not-halt_not-aus_1_schliesser_1_effner_fuer_22-221635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) |  | 31.3 | 1 | 0 | 31.30 | Conrad | New | Link (https://www.conrad.de/de/p/schneider-electric-harmony-xalk178e-pilztaster-im-gehaeuse-120-v-ac-6-a-1-oeffner-1-schliesser-ip66-nach-en-60529-ip67-446473.html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) |  | 47.99 | 1 | 0 | 47.99 | RS Components | New | Link (https://de.rs-online.com/web/p/not-aus-schalter/6094708?searchId=aeb26ca5-0354-4786-934b-362bee1e3ce3) |  | 56.73 | 1 |  | 56.73 |  |  |  |  |  |  |  | 0
74 | Empty housing, 3 holes, 68 x 136 x 53 mm | box | XALD03 |  | Received |  | reichelt | 1 | Link (https://www.reichelt.de/de/de/shop/produkt/leergehaeuse_3_bohrungen_68_x_136_x_53_mm-221680?PROVID=2788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) |  | 22.4 | 1 | 0 | 22.40 | Conrad | New | Link (https://www.conrad.de/de/p/schneider-electric-xald03-xald03-leergehaeuse-3-einbaustellen-b-x-h-x-t-136-x-68-x-53-mm-unbeschriftet-dunkelgrau-hell-446740.html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) |  | 26.99 | 1 | 0 | 26.99 | RS Components | New | Link (https://de.rs-online.com/web/p/steuerstation-gehause/3308436?searchId=f596fa2b-3ff4-439a-8452-0ad45da26ea2) |  | 30.71 | 1 |  | 30.71 |  |  |  |  |  |  |  | 0
68 | Feed-through terminal, PT 2.5 grey | Terminal block | PT 2.5 |  | Received |  | reichelt |  | Link (https://www.reichelt.de/de/de/shop/produkt/durchgangsklemme_pt_2_5_grau-209586?PROVID=2788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) |  | 1 | 80 | 0 | 80.00 | Conrad | New | Link (https://www.conrad.de/de/p/phoenix-contact-3209510-durchgangsklemme-5-2-mm-schnellanschluss-grau-1-st-733311.html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) |  | 1.00 | 80 | 0 | 80.00 | RS Components | New | Link (https://de.rs-online.com/web/p/anschlussklemmenblocke-fur-din-schienen/6879414?matchtype=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) |  | 10.1 | 8 |  | 80.80 |  |  |  |  |  |  |  | 0
69 | Wire end ferrule set, 200 pieces, 0.14 - 0.5 mm² | lug | QUAD 2010C392 |  |  | Supplier not available for the same part no. | reichelt |  | Link (https://www.reichelt.de/de/de/shop/produkt/aderendhuelsen-set_200_stueck_0_14_-_0_5_mm_-360588?PROVID=2788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) |  | 4.8 | 2 | 0 | 9.60 |  |  |  |  |  |  | 0 | 0.00 |  |  |  |  |  |  |  | 0.00 |  |  |  |  |  |  |  | 0
70 | Assortment of insulated wire ferrules 0.5 - 2.5 mm² | lug | AEH RANGE 2 |  | Received |  | reichelt |  | Link (https://www.reichelt.de/de/de/shop/produkt/aderendhuelsen-sortiment_isoliert_0_5_-_2_5_mm_-24731?PROVID=2788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) |  | 4.9 | 3 | 0 | 14.70 |  |  |  |  |  |  | 0 | 0.00 |  |  |  |  |  |  |  | 0.00 |  |  |  |  |  |  |  | 0
75 | Patch cable RJ45 Cat.6A S/FTP 1 m green | Ethernet Cable | BTR 1308451055-E | High | Received |  | reichelt | 1 | Link (https://www.reichelt.de/de/de/shop/produkt/patchkabel_rj45_cat_6a_s_ftp_1_m_gruen-196790) |  | 7.84 | 9 | 0 | 70.56 | Conrad | New | Link (https://www.conrad.de/de/p/metz-connect-1308451055-e-rj45-patchkabel-cat-6a-s-ftp-1-00-m-gruen-mit-rastnasenschutz-1-st-992419.html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) |  | 7.9 | 9 |  | 71.10 | Megatech | New | Link (https://www.megatech-shop.de/products/metz-connect/btr-1308451055-e/1308451055-e-patchkabel-cat6a-2x-rj45-stecker) | 4.66 | 5.55 | 9 | 41.94 | 49.95 |  |  |  |  |  |  |  | 0
71 | Filament, PLA, M0751 black, 750 g | Filament, | ULTIMAKER 74555 |  | Received |  | reichelt |  | Link (https://www.reichelt.de/de/de/shop/produkt/filament_pla_m0751_schwarz_750_g-188516) |  | 41.95 | 1 |  | 41.95 | Conrad | New | Link (https://www.conrad.de/de/p/ultimaker-pla-m0751-black-750-211399-filament-pla-2-85-mm-750-g-schwarz-1-st-1528665.html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) |  | 42.99 | 1 | 0 | 42.99 | 3d Prima | New | Link (https://www.3dprima.com/de/filaments/ultimaker-pla-2-85-mm-750-g-black/a-24685?ReferrerID=121) |  | 42.99 | 1 |  | 42.99 |  |  |  |  |  |  |  | 0
72 | Filament, Tough, PLA, M0777, white, 750 g | Filament, | ULTIMAKER 77662 |  | Received |  | reichelt | 1 | Link (https://www.reichelt.de/de/de/shop/produkt/filament_tough_pla_m0777_weiss_750_g-227293) |  | 52 | 1 |  | 52.00 | Conrad | New | Link (https://www.conrad.de/de/p/ultimaker-filament-tough-tough-pla-schlagfest-2-85-mm-weiss-750-g-1692965.html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) |  | 53.99 | 1 | 0 | 53.99 | 3dmension | New | Link (https://www.3dmensionals.de/ultimaker-tough-pla-filament-2558) |  | 52.00 |  |  | 0.00 |  |  |  |  |  |  |  | 0
76 | Motor Forward Reverse Controller | Controller | TKS-M8 |  | Received | Supplier not available for the same part no. | Amazon |  | Link (https://www.amazon.de/-/en/Forward-Reverse-Controller-TKS-M8-Control/dp/B09SPRMCBW) |  | 15.99 | 3 | 0 | 47.97 |  |  |  |  |  |  | 0 | 0.00 |  |  |  |  |  |  |  | 0.00 |  |  |  |  |  |  |  | 0
77 | Connectors and cables: Sensor-actuator cables | Cable | YG8U13-010VA1XLEAX |  |  |  | Sick |  | Link (https://www.sick.com/de/en/catalog/products/network-and-connection-technology/connectors-and-cables/sensor-actuator-cables/yg8u13-010va1xleax/p/p685406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) |  | 8.5 | 8 | 0 | 68.00 | TME | New | Link (https://www.tme.eu/de/details/yg8u13-100ua1xleax/sensorkabel/sick/) |  | 25.45 | 8 | 0 | 203.60 | RS Components | New | Link (https://de.rs-online.com/web/p/sensor-und-aktor-kabel/2231045?matchtype=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) |  | 10.76 | 8 |  | 86.08 |  |  |  |  |  |  |  | 0
78 | Limit switch | Limit switch | 540-DC1C-A1RB |  | Received | Supplier not available for the same part no. | Mouser |  | Link (https://www.mouser.de/ProductDetail/ZF/DC1C-A1RB?qs=Z7NFYKyvgJf36qdXxs3wkA%3D%3D) | 4.8 | 4.8 | 4 | 19.2 | 19.20 |  |  |  |  |  |  | 0 | 0.00 |  |  |  |  |  |  |  | 0.00 |  |  |  |  |  |  |  | 0
79 | Igus e-chain Black, 30mm x 10.5 mm Igumid G, Length 1 m 38 mm | Drag chain | 720-2777 |  | Received | Supplier not available for the same part no. | RS Components |  | Link (https://de.rs-online.com/web/p/kabelkanale/7202777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) | 28.53 | 33.95 | 1 |  | 33.95 |  |  |  |  |  |  | 0 | 0.00 |  |  |  |  |  |  |  | 0.00 |  |  |  |  |  |  |  | 0
80 | HellermannTyton screw fixing KR mounting base, nylon 6.6 black 18 mm x 6 mm cable ties x 12 mm for 4.5 mm | cable tie holder | 151-24850 |  | Received |  | RS Components | New | Link (https://de.rs-online.com/web/p/kabelbindermontage/0446645?searchId=7c31210a-55c7-4667-b226-b6886aa6cb4f) |  | 61.52 | 1 |  | 61.52 | Conrad | New | Link (https://www.conrad.de/de/p/hellermanntyton-kr8g5-hs-bk-c1-befestigungssockel-schraubbar-151-24850-hitzestabilisiert-schwarz-1-st-547866.html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) |  | 0.88 | 100 | 0 | 88.00 | Farnell |  | Link (https://de.farnell.com/hellermanntyton/kr8g5-black/kabelbinder-befestigungss-7-6mm/dp/1169012) |  | 62.13 | 1 | 0 | 62.13 |  |  |  |  |  |  |  | 0
81 | HellermannTyton T30LOS Nylon 6.6 Cable Ties Non-releasable Black 3.4mm x 200 mm | cable tie | 118-04900 |  | Received |  | RS Components | New | Link (https://de.rs-online.com/web/p/kabelbinder/5424271) |  | 11.52 | 3 |  | 34.56 | Conrad | New | Link (https://www.conrad.de/de/p/hellermanntyton-118-04900-t30los-hs-bk-c1-kabelbinder-200-mm-3-40-mm-schwarz-hitzestabilisiert-100-st-548011.html) |  | 13.99 | 3 | 0 | 41.97 | Farnell |  | Link (https://de.farnell.com/en-DE/hellermanntyton/t30los-hb3p/cable-tie-black-200x3-4mm-pk100/dp/1296254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) |  | 12.4593 | 3 | 0 | 37.38 |  |  |  |  |  |  |  | 0
82 | Silent Compressor SAC55753 | Compressor | SAC55753 |  | Received - OK |  | Profishop | New | Link (https://www.profishop.de/pg/1296951/6badfd7012be893984f6b98a9a5d28109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) |  | 296.51 | 1 | 0 | 296.51 | Hyundai | 1 | Link (https://www.hyundaipower-de.com/hyundai-silent-kompressor-sac55753) |  | 319 | 1 | 0 | 319.00 | Kaufland | New | Link (https://www.kaufland.de/product/376290930/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) |  | 319 | 1 |  | 319.00 |  |  |  |  |  |  |  | 0
84 | Schneider Electric circuit breaker - A9N61508 | 10A 1P | A9N61508 |  | Received |  | Tameson |  | Link (https://tameson.de/products/schneider-electric-leitungsschutzschalter-a9n61508-e33xd) |  | 28.8 | 2 | 0 | 57.60 | Conrad | New | Link (https://www.conrad.de/de/p/schneider-electric-a9n61508-a9n61508-leitungsschutzschalter-10-a-250-v-dc-1861587.html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) |  | 46.33 | 2 | 0 | 92.66 | RS Components | New | Link (https://de.rs-online.com/web/p/leitungsschutzschalter/7721509?matchtype=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) |  | 92.49 | 1 |  | 92.49 |  |  |  |  |  |  |  | 0
83 | Schneider Electric circuit breaker - A9F78216 | 16A MCB 2P | A9F78216 |  | Received |  | Tameson | 1 | Link (https://tameson.de/products/schneider-electric-leitungsschutzschalter-a9f78216-e33uh) |  | 44.39 | 1 | 0 | 44.39 |  |  |  |  |  |  |  | 0.00 | RS Components | New | Link (https://www.conrad.de/de/p/schneider-electric-a9f03216-a9f03216-leitungsschutzschalter-16-a-400-v-1860465.html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) |  | 99.64 | 1 |  | 99.64 |  |  |  |  |  |  |  | 0
85 | Raspberry Pi 5 Starter Kit, 64GB microSDHC including Pi OS, case, power supply | Raspberry pi 5 4 GB |  | High | Received |  | BerryBase |  | Link (https://www.berrybase.de/raspberry-pi-5-starterkit-64gb-microsdhc-inkl.-pi-os-gehaeuse-netzteil-hdmi-kabel-und-zubehoer/farbe-schwarz/ram-4gb) |  | 171.9 | 1 | 0 | 171.90 | Conrad | New | Link (https://www.conrad.de/de/p/raspberry-pi-essentials-kit-raspberry-pi-5-b-8-gb-4-x-2-4-ghz-inkl-netzteil-inkl-gehaeuse-2987744.html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) |  | 215.97 | 1 | 0 | 215.97 | Farnell | New | Link (https://de.farnell.com/multicomp-pro/rpi5-starter-kit-4gb-eu/raspberry-pi-5-starter-kit-4gb/dp/4632381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) |  | 181.63 | 1 |  | 181.63 |  |  |  |  |  |  |  | 0
86 | PUN-H-8X1.25-BL (197385) Plastic hose | 8mm tube | PUN-H-8X1.25-BL |  |  |  | SP Spareparts | New | Link (https://www.sp-spareparts.de/de/p/pun-h-8x1-25-bl-1000-festo?_q=PUN-H-8X1.25-BL) |  | 1.12 | 10 |  | 11.20 | Landefeld | 1 | Link (https://www.landefeld.de/artikel/de/pun-h-8x125-bl-197385-kunststoffschlauch/OT-FESTO014719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) |  | 1.94 | 10 | 0 | 19.40 | RS Components | New | Link (https://de.rs-online.com/web/p/druckluftrohre/1228469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) |  | 96.98 | 1 |  | 96.98
87 | QSML-M5-4 (153333) L-shaped push-in fitting | L fitting | QSML-M5-4 |  | Received |  | SP Spareparts | New | Link (https://www.sp-spareparts.de/de/p/qsml-m5-4-festo?_q=QSML-M5-4) |  | 3.16 | 6 |  | 18.96 | Landefeld | 1 | Link (https://www.landefeld.de/artikel/de/qsml-m5-4-153333-l-steckverschraubung/OT-FESTO015398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) |  | 4.38 | 6 | 0 | 26.28 | RS Components | New | Link (https://de.rs-online.com/web/p/pneumatische-anschlusse/1216023?searchId=7f0296ae-d2af-4e86-b7df-1370d5761b3f) |  | 44.27 | 1 |  | 44.27
88 | ADVC-6-10-APA (188065) short stroke cylinder | Short stroke cylinder | ADVC-6-10-APA (188065) |  | Received |  | SP Spareparts | New | Link (https://www.sp-spareparts.de/de/p/advc-6-10-a-p-a-festo?hsa_cam=23373421648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) |  | 47.02 | 1 |  | 47.02 | Landefeld | 1 | Link (https://www.landefeld.de/artikel/de/advc-6-10-a-p-a-188065-kurzhubzylinder/OT-FESTO003870) |  | 67.6 | 1 | 0 | 67.60 | Fluidics | New | Link (https://fluidics-equipment.com/en/VR-220673.html?___store=en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) |  | 51.82 | 1 |  | 51.82
89 | QSML-M3-4 (153332) L-shaped push-in fitting | M3 fitting | QSML-M3-4 (153332) |  | Received |  | SP Spareparts | New | Link (https://www.sp-spareparts.de/de/p/qsml-m3-4-festo?hsa_cam=23373421648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) |  | 3.42 | 2 |  | 6.84 | Landefeld | 1 | Link (https://www.landefeld.de/artikel/de/qsml-m3-4-153332-l-steckverschraubung/OT-FESTO015396) |  | 6.32 | 2 | 0 | 12.64 | RS Components | New | Link (https://de.rs-online.com/web/p/pneumatische-anschlusse/1216021?matchtype=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) |  | 63.78 | 1 |  | 63.78
90 | QSQ-8-6 (153210) Multi-distributor |  | QSQ-8-6 (153210) |  | Received |  | SP Spareparts | New | Link (https://www.sp-spareparts.de/de/p/qsq-8-6-festo?hsa_cam=23373421648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) |  | 9.09 | 1 |  | 9.09 | Landefeld | 1 | Link (https://www.landefeld.de/artikel/de/qsq-8-6-153210-mehrfachverteiler/OT-FESTO015466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) |  | 12.7 | 1 | 0 | 12.70 | RS Components | New | Link (https://de.rs-online.com/web/p/pneumatische-anschlusse/2024344?matchtype=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) |  | 12.7 | 1 |  | 12.70
91 | PVC conveyor belt, silicone, blue (1E/SHB03) x - welded | Conveyor belt | 5040351 |  |  |  | Z24 | New | Link (https://www.z24.de/a/41850-silikon-blau?verbindungsart=1&laenge=500&breite=40&quantity=2) |  | 47.72 | 2 |  | 95.44 |  |  |  |  |  |  |  | 0.00 |  |  |  |  |  |  |  | 0.00
92 | DOGA DC geared motor type 316 DO 316.9731.3H.00 | Motor | DO 316.9731.3H.00 / 3122 |  |  |  | Conrad | New | Link (https://www.conrad.de/de/p/doga-gleichstrom-getriebemotor-typ-316-do-316-9731-3h-00-3122-24-v-3-a-1-5-nm-65-u-min-wellen-durchmesser-9-mm-1-st-198511.html) |  | 96.63 | 2 |  | 193.26 |  |  |  |  |  |  |  | 0.00 |  |  |  |  |  |  |  | 0.00
93 | Raspberry Pi® SC0940 LCD Monitor Red/White | Rpi monitor | SC0940 |  |  |  | Conrad | New | Link (https://www.conrad.de/de/p/raspberry-pi-sc0940-lcd-monitor-rot-weiss-eek-b-a-g-39-6-cm-15-6-zoll-1920-x-1080-pixel-16-9-hdmi-usb-c-klinke-3364229.html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) |  | 100.83 | 1 |  | 100.83 |  |  |  |  |  |  |  | 0.00 |  |  |  |  |  |  |  | 0.00
94 | FTDI Chip TTL-to-USB-to-Serial Converter Cable for use with USB to TTL UART cable, FTDI Chip | UART cable | TTL-232R-3V3 |  |  |  | RS Components | New | Link (https://de.rs-online.com/web/p/entwicklungstool-zubehor/0429307) | 23.2 | 27.61 | 1 |  | 27.61 | Fernell | 1 | Link (https://de.farnell.com/ftdi/ttl-232r-3v3-2mm/usb-serial-cable-vdrive2-vmusic2/dp/2419943?cjdata=MXxZfDB8WXww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) |  | 28.11 | 1 |  | 28.11 | fruugo |  | Link (https://www.fruugo.de/6-pin-ftdi-ft232rl-ft232-module-for-arduino-usb-to-ttl-uart-serial-wire-adapter-rs232-download-cable-module-minnowboard-max/p-229693245-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) |  | 54 | 1 |  | 54.00
