Ratikantamishranordhausen/MectoSYS/02_Industrial_OT/02_Festo_Automation_Suite/01_Servo Configuration/Components/05d5f970-0fcf-4f49-b288-a2df849870e1/DeviceParameters.csv

#Version:1.1
#PluginType:CMMT-ST
#PluginVer.:2.11.1.7
#SeparatorSign:；
#SystemDecimalSeparator:.
#Role:30
Address；Type；Value；BindableValueText
P0.1.0.0；Festo.Tool.XMLHandler.XMLInterpreterBase.Data.EnumEntry:DiagnosisLevel；4096；DIAGNOSIS_LEVEL_STOP_CATEGORY_0
P0.2.0.0；Festo.Tool.XMLHandler.XMLInterpreterBase.Data.EnumEntry:DiagnosisOptions；1；OPTION_SAVE_TO_LOG
P0.70.0.0；System.UInt32；0x007B5A24；8084004
P0.71.0.0；System.String；CMMT-ST-C8-1C-PN-S0；CMMT-ST-C8-1C-PN-S0
P0.72.0.0；System.String；Rev08；Rev08
P0.73.0.0；System.String；B；B
P0.79.0.0；System.String；；
P0.164.0.0；System.UInt16；0xFFFF；65535
P0.165.0.0；System.UInt16；0xFFFF；65535
P0.166.0.0；System.UInt16；0xFFFF；65535
P0.167.0.0；System.UInt16；0xFFFF；65535
P0.179.0.0；Festo.Tool.XMLHandler.XMLInterpreterBase.Data.EnumEntry:DiagnosisOptions；1；OPTION_SAVE_TO_LOG
P0.181.0.0；Festo.Tool.XMLHandler.XMLInterpreterBase.Data.EnumEntry:DiagnosisLevel；256；DIAGNOSIS_LEVEL_STOP_CATEGORY_1
P0.190.0.0；System.Single；0x00000000；0.00
P0.191.0.0；System.Single；0x00000000；0.00
P0.192.0.0；System.Single；0x00000000；0.00
P0.193.0.0；System.Single；0x00000000；0.00
P0.194.0.0；System.Single；0x00000000；0.00
P0.195.0.0；System.Single；0x00000000；0.00
P0.196.0.0；System.Single；0x00000000；0.00
P0.197.0.0；System.Single；0x00000000；0.00
P0.198.0.0；System.Single；0x00000000；0.00
P0.199.0.0；System.Single；0x00000000；0.00
P0.203.0.0；Festo.Tool.XMLHandler.XMLInterpreterBase.Data.EnumEntry:DiagnosisOptions；1；OPTION_SAVE_TO_LOG
P0.205.0.0；Festo.Tool.XMLHandler.XMLInterpreterBase.Data.EnumEntry:DiagnosisLevel；4；DIAGNOSIS_LEVEL_INFO
P0.209.0.0；System.UInt32；0x00000000；0
P0.209.0.1；System.UInt32；0x00000000；0
P0.209.0.2；System.UInt32；0x00000000；0
P0.209.0.3；System.UInt32；0x00000000；0
P0.209.1.0；System.UInt32；0x00000000；0
P0.209.1.1；System.UInt32；0x00000000；0
P0.209.1.2；System.UInt32；0x00000000；0
P0.209.1.3；System.UInt32；0x00000000；0
P0.244.0.0；Festo.Tool.XMLHandler.XMLInterpreterBase.Data.EnumEntry:ComHardwareType；0；chtNone
P0.245.0.0；Festo.Tool.XMLHandler.XMLInterpreterBase.Data.EnumEntry:ComProtocolType；2；cptPROFINET
P0.246.0.0；System.UInt32；0x00000000；0
P0.247.0.0；System.Byte；0x00；0
P0.247.0.1；System.Byte；0x0E；14
P0.247.0.2；System.Byte；0xF0；240
P0.247.0.3；System.Byte；0x7E；126
P0.247.0.4；System.Byte；0xCB；203
P0.247.0.5；System.Byte；0x1C；28
P0.248.0.0；System.Byte；0x00；0
P0.248.0.1；System.Byte；0x0E；14
P0.248.0.2；System.Byte；0xF0；240
P0.248.0.3；System.Byte；0x7E；126
P0.248.0.4；System.Byte；0xCB；203
P0.248.0.5；System.Byte；0x1D；29
P0.249.0.0；System.Byte；0x00；0
P0.249.0.1；System.Byte；0x0E；14
P0.249.0.2；System.Byte；0xF0；240
P0.249.0.3；System.Byte；0x7E；126
P0.249.0.4；System.Byte；0xCB；203
P0.249.0.5；System.Byte；0x1E；30
P0.250.0.0；System.UInt32；0x007B5A24；8084004
P0.251.0.0；System.String；CMMT-ST-C8-1C-PN-S0；CMMT-ST-C8-1C-PN-S0
P0.253.0.0；System.String；B；B
P0.254.0.0；System.UInt16；0x0001；1
P0.256.0.0；System.Single；0x409CCCCD；4.90
P0.257.0.0；System.Single；0x40B00000；5.50
P0.265.0.0；System.Byte；0x00；0
P0.265.0.1；System.Byte；0x0E；14
P0.265.0.2；System.Byte；0xF0；240
P0.265.0.3；System.Byte；0x7E；126
P0.265.0.4；System.Byte；0xCB；203
P0.265.0.5；System.Byte；0x1F；31
P0.266.0.0；System.String；；
P0.268.0.0；System.String；；
P0.269.0.0；System.UInt32；0x0000943E；37950
P0.305.0.0；Festo.Tool.XMLHandler.XMLInterpreterBase.Data.EnumEntry:DiagnosisLevel；256；DIAGNOSIS_LEVEL_STOP_CATEGORY_1
P0.306.0.0；Festo.Tool.XMLHandler.XMLInterpreterBase.Data.EnumEntry:DiagnosisOptions；1；OPTION_SAVE_TO_LOG
P0.307.0.0；Festo.Tool.XMLHandler.XMLInterpreterBase.Data.EnumEntry:DiagnosisLevel；256；DIAGNOSIS_LEVEL_STOP_CATEGORY_1
P0.308.0.0；Festo.Tool.XMLHandler.XMLInterpreterBase.Data.EnumEntry:DiagnosisOptions；1；OPTION_SAVE_TO_LOG
P0.309.0.0；Festo.Tool.XMLHandler.XMLInterpreterBase.Data.EnumEntry:DiagnosisLevel；1；DIAGNOSIS_LEVEL_INTERNAL
P0.309.1.0；Festo.Tool.XMLHandler.XMLInterpreterBase.Data.EnumEntry:DiagnosisLevel；1；DIAGNOSIS_LEVEL_INTERNAL
P0.311.0.0；System.Single；0x40A80000；5.25
P0.312.0.0；System.UInt32；0x00010000；65536
P0.313.0.0；System.UInt32；0x00001000；4096
P0.320.0.0；Festo.Tool.XMLHandler.XMLInterpreterBase.Data.EnumEntry:Enci_EncoderTypes；0；Enci_Undefined
P0.321.0.0；Festo.Tool.XMLHandler.XMLInterpreterBase.Data.EnumEntry:Enci_EncoderTypes；0；Enci_Undefined
P0.323.0.0；System.Single；0x00000000；0.00
P0.324.0.0；System.Single；0x00000000；0.00
P0.329.0.0；System.UInt32；0x00000000；0
P0.340.0.0；Festo.Tool.XMLHandler.XMLInterpreterBase.Data.EnumEntry:TraceType；1；TRACE_TYPE_DATA_TRACE
P0.341.0.0；Festo.Tool.XMLHandler.XMLInterpreterBase.Data.EnumEntry:TriggerType；1；TRIGGER_TYPE_DATA_TRIGGER
P0.422.0.0；System.UInt32；0x00000000；0
P0.485.0.0；Festo.Tool.XMLHandler.XMLInterpreterBase.Data.EnumEntry:DiagnosisLevel；4096；DIAGNOSIS_LEVEL_STOP_CATEGORY_0
P0.486.0.0；Festo.Tool.XMLHandler.XMLInterpreterBase.Data.EnumEntry:DiagnosisOptions；1；OPTION_SAVE_TO_LOG
P0.487.0.0；Festo.Tool.XMLHandler.XMLInterpreterBase.Data.EnumEntry:DiagnosisLevel；256；DIAGNOSIS_LEVEL_STOP_CATEGORY_1
P0.488.0.0；Festo.Tool.XMLHandler.XMLInterpreterBase.Data.EnumEntry:DiagnosisOptions；1；OPTION_SAVE_TO_LOG
P0.489.0.0；Festo.Tool.XMLHandler.XMLInterpreterBase.Data.EnumEntry:DiagnosisLevel；16；DIAGNOSIS_LEVEL_WARNING
P0.493.0.0；System.Single；0x41900000；18.00
P0.494.0.0；System.Single；0x425CCCCD；55.20
P0.517.0.0；Festo.Tool.XMLHandler.XMLInterpreterBase.Data.EnumEntry:DiagnosisLevel；256；DIAGNOSIS_LEVEL_STOP_CATEGORY_1
P0.518.0.0；Festo.Tool.XMLHandler.XMLInterpreterBase.Data.EnumEntry:DiagnosisOptions；1；OPTION_SAVE_TO_LOG
P0.519.0.0；Festo.Tool.XMLHandler.XMLInterpreterBase.Data.EnumEntry:DiagnosisLevel；256；DIAGNOSIS_LEVEL_STOP_CATEGORY_1
P0.557.0.0；System.Int32；0x000006BE；1726
P0.558.0.0；System.UInt32；0x000008F5；2293
P0.559.0.0；System.UInt32；0x0000000E；14
P0.560.0.0；System.UInt32；0x00000000；0
P0.562.0.0；System.Boolean；False；False
P0.562.0.1；System.Boolean；False；False
P0.562.0.2；System.Boolean；False；False
P0.562.0.3；System.Boolean；False；False
P0.562.0.4；System.Boolean；False；False
P0.562.0.5；System.Boolean；False；False
P0.562.0.6；System.Boolean；False；False
P0.562.0.7；System.Boolean；False；False
P0.562.0.8；System.Boolean；False；False
P0.562.0.9；System.Boolean；False；False
P0.562.0.10；System.Boolean；False；False
P0.562.0.11；System.Boolean；False；False
P0.562.0.12；System.Boolean；False；False
P0.562.0.13；System.Boolean；False；False
P0.562.0.14；System.Boolean；False；False
P0.562.0.15；System.Boolean；False；False
P0.562.0.16；System.Boolean；False；False
P0.562.0.17；System.Boolean；False；False
P0.562.0.18；System.Boolean；False；False
P0.562.0.19；System.Boolean；False；False
P0.562.0.20；System.Boolean；False；False
P0.562.0.21；System.Boolean；False；False
P0.562.0.22；System.Boolean；False；False
P0.562.0.23；System.Boolean；False；False
P0.562.0.24；System.Boolean；False；False
P0.562.0.25；System.Boolean；False；False
P0.562.0.26；System.Boolean；False；False
P0.562.0.27；System.Boolean；False；False
P0.562.0.28；System.Boolean；False；False
P0.562.0.29；System.Boolean；False；False
P0.562.0.30；System.Boolean；False；False
P0.562.0.31；System.Boolean；False；False
P0.562.0.32；System.Boolean；False；False
P0.562.0.33；System.Boolean；False；False
P0.562.0.34；System.Boolean；False；False
P0.562.0.35；System.Boolean；False；False
P0.562.0.36；System.Boolean；False；False
P0.562.0.37；System.Boolean；False；False
P0.562.0.38；System.Boolean；False；False
P0.562.0.39；System.Boolean；False；False
P0.562.0.40；System.Boolean；False；False
P0.562.0.41；System.Boolean；False；False
P0.562.0.42；System.Boolean；False；False
P0.562.0.43；System.Boolean；False；False
P0.562.0.44；System.Boolean；False；False
P0.562.0.45；System.Boolean；False；False
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
P0.2212.0.0；System.UInt16；0x0000；0
P0.2213.0.0；System.String；A；A
P0.2214.0.0；System.UInt16；0x0000；0
P0.2542.0.0；System.Single；0x4048F5C3；3.14
P0.2543.0.0；System.Single；0x405D70A4；3.46
P0.3112.0.0；System.Single；0x38533332；0.000050354
P0.3113.0.0；System.Int32；0x00000000；0
P0.3152.0.0；System.Single；0x3A112CE4；0.0005538
P0.3157.0.0；System.Single；0x38D32EE7；0.0001007
P0.3167.0.0；System.Single；0x38D32EE7；0.0001007
P0.3172.0.0；System.Single；0x389E7099；0.00007555
P0.3173.0.0；System.Int32；0xFFFFFF9C；-100
P0.3177.0.0；System.Single；0x389E607E；0.00007552
P0.3178.0.0；System.Int32；0xFFFFFF9C；-100
P0.3180.0.0；System.Single；0x3F800000；1.00
P0.3181.0.0；System.Single；0x00000000；0.00
P0.3182.0.0；System.Single；0x3F800000；1.00
P0.3183.0.0；System.Single；0x3F800000；1.00
P0.3184.0.0；System.Single；0x00000000；0.00
P0.3185.0.0；System.Single；0x3F800000；1.00
P0.3210.0.0；System.UInt32；0x00000000；0
P0.3212.0.0；System.Boolean；False；False
P0.3213.0.0；System.Boolean；False；False
P0.3215.0.0；System.UInt32；0x00000000；0
P0.3216.0.0；System.UInt32；0x00000000；0
P0.3219.0.0；System.Int64；0x0000000000000000；0
P0.3221.0.0；System.Int64；0x0000000000000000；0.00
P0.3223.0.0；System.Int64；0xFFFFFFFF3958247B；-3.332889477
P0.3225.0.0；System.Boolean；False；False
P0.3226.0.0；System.Boolean；True；True
P0.3228.0.0；System.Boolean；False；False
P0.3229.0.0；System.Boolean；False；False
P0.3232.0.0；Festo.Tool.XMLHandler.XMLInterpreterBase.Data.EnumEntry:DiagnosisLevel；4096；DIAGNOSIS_LEVEL_STOP_CATEGORY_0
P0.3233.0.0；Festo.Tool.XMLHandler.XMLInterpreterBase.Data.EnumEntry:DiagnosisOptions；1；OPTION_SAVE_TO_LOG
P0.3235.0.0；System.Single；0x3A83126F；0.001
P0.3236.0.0；System.Boolean；False；False
P0.3237.0.0；System.Boolean；False；False
P0.3238.0.0；System.UInt32；0x00000000；0
P0.3239.0.0；System.String；；
P0.3240.0.0；System.String；；
P0.3241.0.0；Festo.Tool.XMLHandler.XMLInterpreterBase.Data.EnumEntry:DiagnosisLevel；4096；DIAGNOSIS_LEVEL_STOP_CATEGORY_0
P0.3242.0.0；Festo.Tool.XMLHandler.XMLInterpreterBase.Data.EnumEntry:DiagnosisOptions；1；OPTION_SAVE_TO_LOG
P0.3243.0.0；Festo.Tool.XMLHandler.XMLInterpreterBase.Data.EnumEntry:DiagnosisLevel；4096；DIAGNOSIS_LEVEL_STOP_CATEGORY_0
P0.3244.0.0；Festo.Tool.XMLHandler.XMLInterpreterBase.Data.EnumEntry:DiagnosisOptions；1；OPTION_SAVE_TO_LOG
P0.3245.0.0；Festo.Tool.XMLHandler.XMLInterpreterBase.Data.EnumEntry:DiagnosisLevel；4096；DIAGNOSIS_LEVEL_STOP_CATEGORY_0
P0.3246.0.0；Festo.Tool.XMLHandler.XMLInterpreterBase.Data.EnumEntry:DiagnosisOptions；1；OPTION_SAVE_TO_LOG
P0.3247.0.0；System.Boolean；True；True
P0.3250.0.0；System.Boolean；True；True
P0.3251.0.0；System.Byte；0x00；0
P0.3347.0.0；System.Single；0x3A1FE868；0.00061
P0.3352.0.0；System.Single；0x3A1FE868；0.00061
P0.3357.0.0；System.Single；0x3A1FE868；0.00061
P0.3372.0.0；System.Single；0x38536497；0.0000504
P0.3373.0.0；System.Int32；0x00000000；0
P0.3601.0.0；System.UInt32；0x00000010；16
P0.3602.0.0；System.UInt32；0x00000000；0
P0.3605.0.0；Festo.Tool.XMLHandler.XMLInterpreterBase.Data.EnumEntry:DiagnosisLevel；4096；DIAGNOSIS_LEVEL_STOP_CATEGORY_0
P0.3606.0.0；Festo.Tool.XMLHandler.XMLInterpreterBase.Data.EnumEntry:DiagnosisOptions；1；OPTION_SAVE_TO_LOG
P0.3607.0.0；System.Single；0x40A00000；5.00
P0.3608.0.0；System.Single；0x3F000000；0.50
P0.3609.0.0；System.Boolean；True；True
P0.3611.0.0；System.Byte；0x00；0
P0.3612.0.0；System.UInt32；0x005B8D80；6000000
P0.3613.0.0；System.Boolean；True；True
P0.3614.0.0；System.UInt32；0x00000000；0
P0.3614.0.1；System.UInt32；0x00000000；0
P0.3614.0.2；System.UInt32；0x00000000；0
P0.3614.0.3；System.UInt32；0x00000000；0
P0.3614.0.4；System.UInt32；0x00000000；0
P0.3614.0.5；System.UInt32；0x00000000；0
P0.3614.0.6；System.UInt32；0x00000000；0
P0.3614.0.7；System.UInt32；0x00000000；0
P0.3614.0.8；System.UInt32；0x00000000；0
P0.3614.0.9；System.UInt32；0x00000000；0
P0.3614.0.10；System.UInt32；0x00000000；0
P0.3614.0.11；System.UInt32；0x00000000；0
P0.3614.0.12；System.UInt32；0x00000000；0
P0.3614.0.13；System.UInt32；0x00000000；0
P0.3614.0.14；System.UInt32；0x00000000；0
P0.3614.0.15；System.UInt32；0x00000000；0
P0.3614.0.16；System.UInt32；0x00000000；0
P0.3614.0.17；System.UInt32；0x00000000；0
P0.3614.0.18；System.UInt32；0x00000000；0
P0.3614.0.19；System.UInt32；0x00000000；0
P0.3614.0.20；System.UInt32；0x00000000；0
P0.3614.0.21；System.UInt32；0x00000000；0
P0.3614.0.22；System.UInt32；0x00000000；0
P0.3614.0.23；System.UInt32；0x00000000；0
P0.3614.0.24；System.UInt32；0x00000000；0
P0.3614.0.25；System.UInt32；0x00000000；0
P0.3614.0.26；System.UInt32；0x00000000；0
P0.3614.0.27；System.UInt32；0x00000000；0
P0.3614.0.28；System.UInt32；0x00000000；0
P0.3614.0.29；System.UInt32；0x00000000；0
P0.3614.0.30；System.UInt32；0x00000000；0
P0.3614.0.31；System.UInt32；0x00000000；0
P0.3614.0.32；System.UInt32；0x00000000；0
P0.3614.0.33；System.UInt32；0x00000000；0
P0.3614.0.34；System.UInt32；0x00000000；0
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
P0.5727.0.0；Festo.Tool.XMLHandler.XMLInterpreterBase.Data.EnumEntry:DiagnosisOptions；1；OPTION_SAVE_TO_LOG
P0.5729.0.0；Festo.Tool.XMLHandler.XMLInterpreterBase.Data.EnumEntry:PmLoadedParameterset；1；PmLoadedParameterset_Slot1
P0.5760.0.0；System.String；B；B
P0.5761.0.0；System.UInt16；0x0000；0
P0.5762.0.0；System.UInt16；0x0001；1
P0.5763.0.0；System.String；B；B
P0.5764.0.0；System.UInt16；0x0000；0
P0.5765.0.0；System.UInt16；0x0001；1
P0.5766.0.0；System.String；B；B
P0.5767.0.0；System.UInt16；0x0000；0
P0.5768.0.0；System.UInt16；0x0001；1
P0.5769.0.0；System.String；B；B
P0.5770.0.0；System.UInt16；0x0000；0
P0.5771.0.0；System.UInt16；0x0001；1
P0.5772.0.0；System.String；BL-CMMTST-V1-PN；BL-CMMTST-V1-PN
P0.5773.0.0；System.String；FW-CMMTST-V1-PN；FW-CMMTST-V1-PN
P0.5774.0.0；System.String；ENGP-CMMTST-V1-PN；ENGP-CMMTST-V1-PN
P0.5775.0.0；System.String；；
P0.5776.0.0；System.String；COM-CMMTST-V1-PN；COM-CMMTST-V1-PN
P0.5777.0.0；System.String；EXT-CMMTST-V1-PN；EXT-CMMTST-V1-PN
P0.5780.0.0；Festo.Tool.XMLHandler.XMLInterpreterBase.Data.EnumEntry:DiagnosisLevel；16；DIAGNOSIS_LEVEL_WARNING
P0.5781.0.0；Festo.Tool.XMLHandler.XMLInterpreterBase.Data.EnumEntry:DiagnosisOptions；1；OPTION_SAVE_TO_LOG
P0.5782.0.0；Festo.Tool.XMLHandler.XMLInterpreterBase.Data.EnumEntry:DiagnosisLevel；16；DIAGNOSIS_LEVEL_WARNING
P0.5783.0.0；Festo.Tool.XMLHandler.XMLInterpreterBase.Data.EnumEntry:DiagnosisOptions；1；OPTION_SAVE_TO_LOG
P0.6000.0.0；System.UInt16；0x0001；1
P0.6001.0.0；System.UInt32；0x0001B8B3；112819
P0.6002.0.0；System.UInt16；0x0000；0
P0.6003.0.0；System.UInt16；0x0000；0
P0.6004.0.0；Festo.Tool.XMLHandler.XMLInterpreterBase.Data.EnumEntry:TriggerEvent；3；TRIGGER_EVENT_VALUE_CHANGE
P0.7110.0.0；System.Single；0x00000000；0.00
P0.7113.0.0；System.Boolean；False；False
P0.7116.0.0；System.Single；0x3DCCCCCD；0.10
P0.7119.0.0；System.Single；0x3E99999A；0.30
P0.7122.0.0；System.Single；0x3DCCCCCD；0.10
P0.7125.0.0；System.Single；0x3DCCCCCD；0.10
P0.7128.0.0；System.Single；0x00000000；0.00
P0.7131.0.0；System.Single；0x00000000；0.00
P0.7134.0.0；System.Single；0x3F800000；1.00
P0.7143.0.0；System.Single；0x40000000；2.00
P0.7146.0.0；System.Single；0x3DCCCCCD；0.10
P0.7149.0.0；System.Single；0x3DCCCCCD；0.10
P0.7150.0.0；System.String；；
P0.7151.0.0；System.UInt16；0x0000；0
P0.7152.0.0；Festo.Tool.XMLHandler.XMLInterpreterBase.Data.EnumEntry:TemperatureSensorType；0；TEMPSENSOR_TYPE_NOT_CONNECTED
P0.7155.0.0；System.Single；0x00000000；0.00
P0.7155.0.1；System.Single；0x00000000；0.00
P0.7158.0.0；System.Boolean；False；False
P0.7161.0.0；System.Single；0x00000000；0.00
P0.7164.0.0；System.Single；0x00000000；0.00
P0.7171.0.0；System.UInt32；0x00000001；1
P0.7181.0.0；System.Single；0x3DCCCCCD；0.10
P0.7183.0.0；System.UInt32；0x00000000；0
P0.7186.0.0；System.String；；
P0.7187.0.0；System.UInt16；0x0000；0
P0.7428.0.0；System.Single；0x00000000；0.00
P0.7429.0.0；System.Single；0x00000000；0.00
P0.7430.0.0；Festo.Tool.XMLHandler.XMLInterpreterBase.Data.EnumEntry:MotorType；1；MotorTypeStepper
P0.9004.0.0；Festo.Tool.XMLHandler.XMLInterpreterBase.Data.EnumEntry:DiagnosisLevel；4；DIAGNOSIS_LEVEL_INFO
P0.9005.0.0；Festo.Tool.XMLHandler.XMLInterpreterBase.Data.EnumEntry:DiagnosisOptions；1；OPTION_SAVE_TO_LOG
P0.9006.0.0；Festo.Tool.XMLHandler.XMLInterpreterBase.Data.EnumEntry:DiagnosisLevel；4；DIAGNOSIS_LEVEL_INFO
P0.9007.0.0；Festo.Tool.XMLHandler.XMLInterpreterBase.Data.EnumEntry:DiagnosisOptions；1；OPTION_SAVE_TO_LOG
P0.9301.0.0；Festo.Tool.XMLHandler.XMLInterpreterBase.Data.EnumEntry:DiagnosisLevel；4；DIAGNOSIS_LEVEL_INFO
P0.9302.0.0；Festo.Tool.XMLHandler.XMLInterpreterBase.Data.EnumEntry:DiagnosisOptions；1；OPTION_SAVE_TO_LOG
P0.9303.0.0；System.Byte；0x0A；10
P0.9304.0.0；System.Byte；0x14；20
P0.9305.0.0；System.Byte；0x1E；30
P0.9306.0.0；System.Byte；0x28；40
P0.9307.0.0；System.Byte；0x32；50
P0.9308.0.0；System.Byte；0x3C；60
P0.9309.0.0；System.Byte；0x46；70
P0.9310.0.0；System.Single；0x428C0000；70.00
P0.9311.0.0；System.Single；0x42A00000；80.00
P0.9312.0.0；System.Single；0x00000000；0.00
P0.9313.0.0；System.Single；0xC1200000；-10.00
P0.9314.0.0；System.Single；0x42AA0000；85.00
P0.9315.0.0；System.Single；0x42BE0000；95.00
P0.9316.0.0；System.Single；0x00000000；0.00
P0.9317.0.0；System.Single；0xC1200000；-10.00
P0.9550.0.0；System.String；V24.0.2.121_release；V24.0.2.121_release
P0.9560.0.0；System.UInt32；0x00000018；24
P0.9570.0.0；System.UInt32；0x00000000；0
P0.9580.0.0；System.UInt32；0x00000002；2
P0.9590.0.0；System.UInt32；0x00000079；121
P0.9600.0.0；Festo.Tool.XMLHandler.XMLInterpreterBase.Data.EnumEntry:DiagnosisLevel；16；DIAGNOSIS_LEVEL_WARNING
P0.9601.0.0；Festo.Tool.XMLHandler.XMLInterpreterBase.Data.EnumEntry:DiagnosisOptions；1；OPTION_SAVE_TO_LOG
P0.9602.0.0；Festo.Tool.XMLHandler.XMLInterpreterBase.Data.EnumEntry:DiagnosisLevel；16；DIAGNOSIS_LEVEL_WARNING
P0.9603.0.0；Festo.Tool.XMLHandler.XMLInterpreterBase.Data.EnumEntry:DiagnosisOptions；1；OPTION_SAVE_TO_LOG
P0.9604.0.0；Festo.Tool.XMLHandler.XMLInterpreterBase.Data.EnumEntry:DiagnosisLevel；16；DIAGNOSIS_LEVEL_WARNING
P0.9605.0.0；Festo.Tool.XMLHandler.XMLInterpreterBase.Data.EnumEntry:DiagnosisOptions；1；OPTION_SAVE_TO_LOG
P0.9606.0.0；Festo.Tool.XMLHandler.XMLInterpreterBase.Data.EnumEntry:DiagnosisLevel；16；DIAGNOSIS_LEVEL_WARNING
P0.9607.0.0；Festo.Tool.XMLHandler.XMLInterpreterBase.Data.EnumEntry:DiagnosisOptions；1；OPTION_SAVE_TO_LOG
P0.9608.0.0；Festo.Tool.XMLHandler.XMLInterpreterBase.Data.EnumEntry:DiagnosisLevel；16；DIAGNOSIS_LEVEL_WARNING
P0.9609.0.0；Festo.Tool.XMLHandler.XMLInterpreterBase.Data.EnumEntry:DiagnosisOptions；1；OPTION_SAVE_TO_LOG
P0.9610.0.0；Festo.Tool.XMLHandler.XMLInterpreterBase.Data.EnumEntry:DiagnosisLevel；16；DIAGNOSIS_LEVEL_WARNING
P0.9611.0.0；Festo.Tool.XMLHandler.XMLInterpreterBase.Data.EnumEntry:DiagnosisOptions；1；OPTION_SAVE_TO_LOG
P0.9612.0.0；Festo.Tool.XMLHandler.XMLInterpreterBase.Data.EnumEntry:DiagnosisLevel；16；DIAGNOSIS_LEVEL_WARNING
P0.9613.0.0；Festo.Tool.XMLHandler.XMLInterpreterBase.Data.EnumEntry:DiagnosisOptions；1；OPTION_SAVE_TO_LOG
P0.9614.0.0；Festo.Tool.XMLHandler.XMLInterpreterBase.Data.EnumEntry:DiagnosisLevel；16；DIAGNOSIS_LEVEL_WARNING
P0.9615.0.0；Festo.Tool.XMLHandler.XMLInterpreterBase.Data.EnumEntry:DiagnosisOptions；1；OPTION_SAVE_TO_LOG
P0.9616.0.0；Festo.Tool.XMLHandler.XMLInterpreterBase.Data.EnumEntry:DiagnosisLevel；256；DIAGNOSIS_LEVEL_STOP_CATEGORY_1
P0.9617.0.0；Festo.Tool.XMLHandler.XMLInterpreterBase.Data.EnumEntry:DiagnosisOptions；1；OPTION_SAVE_TO_LOG
P0.9618.0.0；Festo.Tool.XMLHandler.XMLInterpreterBase.Data.EnumEntry:DiagnosisLevel；256；DIAGNOSIS_LEVEL_STOP_CATEGORY_1
P0.9619.0.0；Festo.Tool.XMLHandler.XMLInterpreterBase.Data.EnumEntry:DiagnosisOptions；1；OPTION_SAVE_TO_LOG
P0.9620.0.0；System.Byte；0x00；0
P0.9700.0.0；Festo.Tool.XMLHandler.XMLInterpreterBase.Data.EnumEntry:DiagnosisLevel；256；DIAGNOSIS_LEVEL_STOP_CATEGORY_1
P0.9701.0.0；Festo.Tool.XMLHandler.XMLInterpreterBase.Data.EnumEntry:DiagnosisOptions；1；OPTION_SAVE_TO_LOG
P0.9702.0.0；Festo.Tool.XMLHandler.XMLInterpreterBase.Data.EnumEntry:DiagnosisLevel；64；DIAGNOSIS_LEVEL_STOP_CATEGORY_2
P0.9703.0.0；Festo.Tool.XMLHandler.XMLInterpreterBase.Data.EnumEntry:DiagnosisOptions；1；OPTION_SAVE_TO_LOG
P0.10040.0.0；System.UInt16；0x01F4；500
P0.10043.0.0；System.Byte；0x04；4
P0.10044.0.0；System.Boolean；False；False
P0.10045.0.0；System.Boolean；False；False
P0.10046.0.0；System.Single；0x40A80000；5.25
P0.10047.0.0；System.UInt16；0x0003；3
P0.10049.0.0；System.Single；0x3E800000；0.25
P0.10051.0.0；Festo.Tool.XMLHandler.XMLInterpreterBase.Data.EnumEntry:QuadratureEncoderFilterTime；3；FilterTime80ns
P0.10053.0.0；System.Single；0x3F19999A；0.60
P0.10054.0.0；System.Single；0x3DCCCCCD；0.10
P0.10055.0.0；Festo.Tool.XMLHandler.XMLInterpreterBase.Data.EnumEntry:DiagnosisOptions；1；OPTION_SAVE_TO_LOG
P0.10056.0.0；Festo.Tool.XMLHandler.XMLInterpreterBase.Data.EnumEntry:DiagnosisLevel；4096；DIAGNOSIS_LEVEL_STOP_CATEGORY_0
P0.10059.0.0；System.Single；0x40C80000；6.25
P0.10060.0.0；Festo.Tool.XMLHandler.XMLInterpreterBase.Data.EnumEntry:DiagnosisOptions；1；OPTION_SAVE_TO_LOG
P0.10061.0.0；Festo.Tool.XMLHandler.XMLInterpreterBase.Data.EnumEntry:DiagnosisLevel；16；DIAGNOSIS_LEVEL_WARNING
P0.10171.0.0；Festo.Tool.XMLHandler.XMLInterpreterBase.Data.EnumEntry:DiagnosisLevel；256；DIAGNOSIS_LEVEL_STOP_CATEGORY_1
P0.10172.0.0；Festo.Tool.XMLHandler.XMLInterpreterBase.Data.EnumEntry:DiagnosisOptions；1；OPTION_SAVE_TO_LOG
P0.10183.0.0；System.Boolean；True；True
P0.10184.0.0；System.Boolean；True；True
P0.10185.0.0；System.Single；0x41F00000；30.00
P0.10186.0.0；System.Single；0x3DCCCCCD；0.10
P0.10187.0.0；Festo.Tool.XMLHandler.XMLInterpreterBase.Data.EnumEntry:DiagnosisLevel；256；DIAGNOSIS_LEVEL_STOP_CATEGORY_1
P0.10188.0.0；Festo.Tool.XMLHandler.XMLInterpreterBase.Data.EnumEntry:DiagnosisOptions；1；OPTION_SAVE_TO_LOG
P0.10189.0.0；System.Single；0x3ECCCCCD；0.40
P0.10191.0.0；Festo.Tool.XMLHandler.XMLInterpreterBase.Data.EnumEntry:IoMode；0；NPN
P0.10325.0.0；Festo.Tool.XMLHandler.XMLInterpreterBase.Data.EnumEntry:DiagnosisLevel；4096；DIAGNOSIS_LEVEL_STOP_CATEGORY_0
P0.10326.0.0；Festo.Tool.XMLHandler.XMLInterpreterBase.Data.EnumEntry:DiagnosisOptions；1；OPTION_SAVE_TO_LOG
P0.10327.0.0；Festo.Tool.XMLHandler.XMLInterpreterBase.Data.EnumEntry:DiagnosisLevel；16；DIAGNOSIS_LEVEL_WARNING
P0.10328.0.0；Festo.Tool.XMLHandler.XMLInterpreterBase.Data.EnumEntry:DiagnosisOptions；1；OPTION_SAVE_TO_LOG
P0.10426.0.0；Festo.Tool.XMLHandler.XMLInterpreterBase.Data.EnumEntry:DiagnosisOptions；1；OPTION_SAVE_TO_LOG
P0.10427.0.0；Festo.Tool.XMLHandler.XMLInterpreterBase.Data.EnumEntry:DiagnosisLevel；4096；DIAGNOSIS_LEVEL_STOP_CATEGORY_0
P0.11201.0.0；Festo.Tool.XMLHandler.XMLInterpreterBase.Data.EnumEntry:InputFunctionId；1；IN_NO_FUNCTION
P0.11202.0.0；Festo.Tool.XMLHandler.XMLInterpreterBase.Data.EnumEntry:InputFunctionId；1；IN_NO_FUNCTION
P0.11203.0.0；Festo.Tool.XMLHandler.XMLInterpreterBase.Data.EnumEntry:OutputFunctionId；1；OUT_NO_FUNCTION
P0.11204.0.0；Festo.Tool.XMLHandler.XMLInterpreterBase.Data.EnumEntry:OutputFunctionId；1；OUT_NO_FUNCTION
P0.11205.0.0；Festo.Tool.XMLHandler.XMLInterpreterBase.Data.EnumEntry:InputFunctionId；1；IN_NO_FUNCTION
P0.11308.0.0；Festo.Tool.XMLHandler.XMLInterpreterBase.Data.EnumEntry:DiagnosisLevel；256；DIAGNOSIS_LEVEL_STOP_CATEGORY_1
P0.11309.0.0；Festo.Tool.XMLHandler.XMLInterpreterBase.Data.EnumEntry:DiagnosisOptions；1；OPTION_SAVE_TO_LOG
P0.11310.0.0；System.UInt16；0x0000；0
P0.11608.0.0；System.Int64；0x0000000000000000；0
P0.11616.0.0；Festo.Tool.XMLHandler.XMLInterpreterBase.Data.EnumEntry:ENCC_EncoderTypes；4；ENCC_Increment
P0.11618.0.0；System.Single；0x3A83126F；0.001
P0.11622.0.0；Festo.Tool.XMLHandler.XMLInterpreterBase.Data.EnumEntry:DiagnosisOptions；1；OPTION_SAVE_TO_LOG
P0.11623.0.0；Festo.Tool.XMLHandler.XMLInterpreterBase.Data.EnumEntry:DiagnosisLevel；4；DIAGNOSIS_LEVEL_INFO
P0.11624.0.0；Festo.Tool.XMLHandler.XMLInterpreterBase.Data.EnumEntry:DiagnosisOptions；1；OPTION_SAVE_TO_LOG
P0.11625.0.0；Festo.Tool.XMLHandler.XMLInterpreterBase.Data.EnumEntry:DiagnosisLevel；4；DIAGNOSIS_LEVEL_INFO
P0.11626.0.0；System.Boolean；True；True
P0.12000.0.0；System.Boolean；False；False
P0.12000.1.0；System.Boolean；False；False
P0.12001.0.0；System.UInt32；0xC0A80001；3232235521
P0.12001.1.0；System.UInt32；0xC0A80002；3232235522
P0.12002.0.0；System.UInt32；0xFFFFFF00；4294967040
P0.12002.1.0；System.UInt32；0xFFFFFF00；4294967040
P0.12003.0.0；System.UInt32；0x00000000；0
P0.12003.1.0；System.UInt32；0x00000000；0
P0.12008.0.0；System.Boolean；True；True
P0.12009.0.0；System.UInt32；0x00001388；5000
P0.12010.0.0；System.UInt32；0x000003E8；1000
P0.12011.0.0；System.UInt32；0x0000000A；10
P0.17750.0.0；Festo.Tool.XMLHandler.XMLInterpreterBase.Data.EnumEntry:DiagnosisLevel；4096；DIAGNOSIS_LEVEL_STOP_CATEGORY_0
P0.17751.0.0；Festo.Tool.XMLHandler.XMLInterpreterBase.Data.EnumEntry:DiagnosisOptions；1；OPTION_SAVE_TO_LOG
P0.17752.0.0；Festo.Tool.XMLHandler.XMLInterpreterBase.Data.EnumEntry:DiagnosisLevel；4096；DIAGNOSIS_LEVEL_STOP_CATEGORY_0
P0.17753.0.0；Festo.Tool.XMLHandler.XMLInterpreterBase.Data.EnumEntry:DiagnosisOptions；1；OPTION_SAVE_TO_LOG
P0.17754.0.0；Festo.Tool.XMLHandler.XMLInterpreterBase.Data.EnumEntry:DiagnosisLevel；4096；DIAGNOSIS_LEVEL_STOP_CATEGORY_0
P0.17755.0.0；Festo.Tool.XMLHandler.XMLInterpreterBase.Data.EnumEntry:DiagnosisOptions；1；OPTION_SAVE_TO_LOG
P0.17756.0.0；Festo.Tool.XMLHandler.XMLInterpreterBase.Data.EnumEntry:DiagnosisLevel；4096；DIAGNOSIS_LEVEL_STOP_CATEGORY_0
P0.17757.0.0；Festo.Tool.XMLHandler.XMLInterpreterBase.Data.EnumEntry:DiagnosisOptions；1；OPTION_SAVE_TO_LOG
P0.17758.0.0；Festo.Tool.XMLHandler.XMLInterpreterBase.Data.EnumEntry:DiagnosisLevel；4096；DIAGNOSIS_LEVEL_STOP_CATEGORY_0
P0.17759.0.0；Festo.Tool.XMLHandler.XMLInterpreterBase.Data.EnumEntry:DiagnosisOptions；1；OPTION_SAVE_TO_LOG
P0.17760.0.0；Festo.Tool.XMLHandler.XMLInterpreterBase.Data.EnumEntry:DiagnosisLevel；4096；DIAGNOSIS_LEVEL_STOP_CATEGORY_0
P0.17761.0.0；Festo.Tool.XMLHandler.XMLInterpreterBase.Data.EnumEntry:DiagnosisOptions；1；OPTION_SAVE_TO_LOG
P0.17762.0.0；Festo.Tool.XMLHandler.XMLInterpreterBase.Data.EnumEntry:DiagnosisLevel；4096；DIAGNOSIS_LEVEL_STOP_CATEGORY_0
P0.17763.0.0；Festo.Tool.XMLHandler.XMLInterpreterBase.Data.EnumEntry:DiagnosisOptions；1；OPTION_SAVE_TO_LOG
P0.17764.0.0；Festo.Tool.XMLHandler.XMLInterpreterBase.Data.EnumEntry:DiagnosisLevel；4096；DIAGNOSIS_LEVEL_STOP_CATEGORY_0
P0.17765.0.0；Festo.Tool.XMLHandler.XMLInterpreterBase.Data.EnumEntry:DiagnosisOptions；1；OPTION_SAVE_TO_LOG
P0.17766.0.0；Festo.Tool.XMLHandler.XMLInterpreterBase.Data.EnumEntry:DiagnosisLevel；4096；DIAGNOSIS_LEVEL_STOP_CATEGORY_0
P0.17767.0.0；Festo.Tool.XMLHandler.XMLInterpreterBase.Data.EnumEntry:DiagnosisOptions；1；OPTION_SAVE_TO_LOG
P0.20810.0.0；Festo.Tool.XMLHandler.XMLInterpreterBase.Data.EnumEntry:DiagnosisLevel；256；DIAGNOSIS_LEVEL_STOP_CATEGORY_1
P0.20811.0.0；Festo.Tool.XMLHandler.XMLInterpreterBase.Data.EnumEntry:DiagnosisOptions；1；OPTION_SAVE_TO_LOG
P0.26782.0.0；System.String；；
P0.31220.0.0；System.Int32；0x00008000；32768
P0.31221.0.0；System.Int32；0x00008000；32768
P0.31222.0.0；System.Int32；0x00008000；32768
P0.31235.0.0；System.Single；0x3A83126F；0.001
P0.31236.0.0；System.Single；0x3903126F；0.000125
P0.31237.0.0；System.Single；0x3903126F；0.000125
P0.31238.0.0；System.UInt16；0x0001；1
P0.33310.0.0；System.Single；0x40533333；3.30
P0.33311.0.0；System.String；；
P0.33312.0.0；System.UInt16；0x0000；0
P0.34010.0.0；System.Boolean；False；False
P0.34011.0.0；System.UInt32；0x00000000；0
P0.34011.0.1；System.UInt32；0x00000000；0
P0.34011.0.2；System.UInt32；0x00000000；0
P0.34011.0.3；System.UInt32；0x00000000；0
P0.34011.0.4；System.UInt32；0x00000000；0
P0.34011.0.5；System.UInt32；0x00000000；0
P0.34011.0.6；System.UInt32；0x00000000；0
P0.34011.0.7；System.UInt32；0x00000000；0
P0.34012.0.0；System.Byte；0x00；0
P0.34012.0.1；System.Byte；0x00；0
P0.34012.0.2；System.Byte；0x00；0
P0.34012.0.3；System.Byte；0x00；0
P0.34012.0.4；System.Byte；0x00；0
P0.34012.0.5；System.Byte；0x00；0
P0.34012.0.6；System.Byte；0x00；0
P0.34012.0.7；System.Byte；0x00；0
P0.54543.0.0；Festo.Tool.XMLHandler.XMLInterpreterBase.Data.EnumEntry:ProfiNetState；10；ProfiNetOnNoSync
P0.54545.0.0；Festo.Tool.XMLHandler.XMLInterpreterBase.Data.EnumEntry:DiagnosisLevel；256；DIAGNOSIS_LEVEL_STOP_CATEGORY_1
P0.54546.0.0；Festo.Tool.XMLHandler.XMLInterpreterBase.Data.EnumEntry:DiagnosisOptions；1；OPTION_SAVE_TO_LOG
P0.60012.0.0；System.Boolean；True；True
P0.60013.0.0；System.UInt64；0xFFFFFFFFFFFFFFFF；18446744073709551615
P0.71502.0.0；System.Single；0x3C23D70A；0.01
P0.71503.0.0；System.Single；0x00000000；0.00
P0.100025.0.0；System.Boolean；False；False
P0.100027.0.0；System.UInt32；0x000186A0；100000
P0.100504.0.0；Festo.Tool.XMLHandler.XMLInterpreterBase.Data.EnumEntry:DiagnosisLevel；16；DIAGNOSIS_LEVEL_WARNING
P0.100505.0.0；Festo.Tool.XMLHandler.XMLInterpreterBase.Data.EnumEntry:DiagnosisOptions；1；OPTION_SAVE_TO_LOG
P0.100508.0.0；Festo.Tool.XMLHandler.XMLInterpreterBase.Data.EnumEntry:DiagnosisLevel；16；DIAGNOSIS_LEVEL_WARNING
P0.100556.0.0；System.Boolean；False；False
P0.101125.0.0；Festo.Tool.XMLHandler.XMLInterpreterBase.Data.EnumEntry:DiagnosisOptions；1；OPTION_SAVE_TO_LOG
P0.101127.0.0；Festo.Tool.XMLHandler.XMLInterpreterBase.Data.EnumEntry:DiagnosisLevel；16；DIAGNOSIS_LEVEL_WARNING
P0.103100.0.0；System.UInt16；0x0000；0
P0.103101.0.0；System.UInt32；0x00000000；0
P0.103102.0.0；System.UInt16；0x0000；0
P0.103106.0.0；Festo.Tool.XMLHandler.XMLInterpreterBase.Data.EnumEntry:DiagnosisTriggerEvent；0；TRIGGER_EVENT
P0.103300.0.0；System.UInt16；0x0000；0
P0.103300.0.1；System.UInt16；0x0000；0
P0.103300.0.2；System.UInt16；0x0000；0
P0.103300.0.3；System.UInt16；0x0000；0
P0.103301.0.0；System.UInt32；0x00000000；0
P0.103301.0.1；System.UInt32；0x00000000；0
P0.103301.0.2；System.UInt32；0x00000000；0
P0.103301.0.3；System.UInt32；0x00000000；0
P0.103302.0.0；System.UInt16；0x0000；0
P0.103302.0.1；System.UInt16；0x0000；0
P0.103302.0.2；System.UInt16；0x0000；0
P0.103302.0.3；System.UInt16；0x0000；0
P0.103303.0.0；Festo.Tool.XMLHandler.XMLInterpreterBase.Data.EnumEntry:DiagnosisLevel；0；DIAGNOSIS_LEVEL_INVALID
P0.103303.0.1；Festo.Tool.XMLHandler.XMLInterpreterBase.Data.EnumEntry:DiagnosisLevel；0；DIAGNOSIS_LEVEL_INVALID
P0.103303.0.2；Festo.Tool.XMLHandler.XMLInterpreterBase.Data.EnumEntry:DiagnosisLevel；0；DIAGNOSIS_LEVEL_INVALID
P0.103303.0.3；Festo.Tool.XMLHandler.XMLInterpreterBase.Data.EnumEntry:DiagnosisLevel；0；DIAGNOSIS_LEVEL_INVALID
P0.103304.0.0；Festo.Tool.XMLHandler.XMLInterpreterBase.Data.EnumEntry:DiagnosisOptions；0；OPTION_NONE
P0.103304.0.1；Festo.Tool.XMLHandler.XMLInterpreterBase.Data.EnumEntry:DiagnosisOptions；0；OPTION_NONE
P0.103304.0.2；Festo.Tool.XMLHandler.XMLInterpreterBase.Data.EnumEntry:DiagnosisOptions；0；OPTION_NONE
P0.103304.0.3；Festo.Tool.XMLHandler.XMLInterpreterBase.Data.EnumEntry:DiagnosisOptions；0；OPTION_NONE
P0.103305.0.0；System.UInt32；0x00000001；1
P0.103306.0.0；System.Boolean；False；False
P0.103307.0.0；System.Single；0x3A83126F；0.001
P0.103308.0.0；Festo.Tool.XMLHandler.XMLInterpreterBase.Data.EnumEntry:DiagnosisTriggerEvent；2；ANY_EVENT
P0.112446.0.0；Festo.Tool.XMLHandler.XMLInterpreterBase.Data.EnumEntry:DiagnosisLevel；4096；DIAGNOSIS_LEVEL_STOP_CATEGORY_0
P0.112447.0.0；Festo.Tool.XMLHandler.XMLInterpreterBase.Data.EnumEntry:DiagnosisOptions；1；OPTION_SAVE_TO_LOG
P0.112448.0.0；System.Boolean；True；True
P0.112901.0.0；System.UInt16；0x0000；0
P0.112902.0.0；System.UInt16；0x0000；0
P0.112903.0.0；System.UInt16；0x0000；0
P0.324234.0.0；Festo.Tool.XMLHandler.XMLInterpreterBase.Data.EnumEntry:DiagnosisOptions；1；OPTION_SAVE_TO_LOG
P0.342435.0.0；Festo.Tool.XMLHandler.XMLInterpreterBase.Data.EnumEntry:DiagnosisLevel；4096；DIAGNOSIS_LEVEL_STOP_CATEGORY_0
P0.522622.0.0；System.Single；0x3F800000；1.00
P0.522623.0.0；System.Single；0x3F000000；0.50
P0.526774.0.0；Festo.Tool.XMLHandler.XMLInterpreterBase.Data.EnumEntry:DiagnosisLevel；4；DIAGNOSIS_LEVEL_INFO
P0.526775.0.0；Festo.Tool.XMLHandler.XMLInterpreterBase.Data.EnumEntry:DiagnosisLevel；4096；DIAGNOSIS_LEVEL_STOP_CATEGORY_0
P0.526776.0.0；Festo.Tool.XMLHandler.XMLInterpreterBase.Data.EnumEntry:DiagnosisOptions；0；OPTION_NONE
P0.526777.0.0；Festo.Tool.XMLHandler.XMLInterpreterBase.Data.EnumEntry:DiagnosisOptions；1；OPTION_SAVE_TO_LOG
P0.526785.0.0；System.Single；0x40000000；2.00
P0.526798.0.0；Festo.Tool.XMLHandler.XMLInterpreterBase.Data.EnumEntry:DiagnosisLevel；256；DIAGNOSIS_LEVEL_STOP_CATEGORY_1
P0.526900.0.0；Festo.Tool.XMLHandler.XMLInterpreterBase.Data.EnumEntry:DiagnosisOptions；1；OPTION_SAVE_TO_LOG
P0.526914.0.0；System.Single；0x3BA3D70A；0.005
P0.526915.0.0；Festo.Tool.XMLHandler.XMLInterpreterBase.Data.EnumEntry:DiagnosisOptions；1；OPTION_SAVE_TO_LOG
P0.526916.0.0；Festo.Tool.XMLHandler.XMLInterpreterBase.Data.EnumEntry:DiagnosisLevel；256；DIAGNOSIS_LEVEL_STOP_CATEGORY_1
P0.1174200.0.0；System.Boolean；False；False
P0.1174201.0.0；System.UInt16；0x0000；0
P0.1174202.0.0；System.UInt32；0x00000000；0
P0.1174203.0.0；System.UInt16；0x0000；0
P0.1174204.0.0；System.UInt16；0x0000；0
P0.1174205.0.0；System.Int64；0x0000000000000000；0
P0.1174206.0.0；System.Int64；0x0000000000000000；0
P0.1174207.0.0；System.Single；0x00000000；0.00
P0.1174230.0.0；Festo.Tool.XMLHandler.XMLInterpreterBase.Data.EnumEntry:DiagnosisLevel；16；DIAGNOSIS_LEVEL_WARNING
P0.1174231.0.0；Festo.Tool.XMLHandler.XMLInterpreterBase.Data.EnumEntry:DiagnosisOptions；1；OPTION_SAVE_TO_LOG
P0.5261794.0.0；Festo.Tool.XMLHandler.XMLInterpreterBase.Data.EnumEntry:DiagnosisLevel；4096；DIAGNOSIS_LEVEL_STOP_CATEGORY_0
P0.5261795.0.0；Festo.Tool.XMLHandler.XMLInterpreterBase.Data.EnumEntry:DiagnosisOptions；1；OPTION_SAVE_TO_LOG
P0.5261798.0.0；Festo.Tool.XMLHandler.XMLInterpreterBase.Data.EnumEntry:DiagnosisLevel；256；DIAGNOSIS_LEVEL_STOP_CATEGORY_1
P0.5261799.0.0；Festo.Tool.XMLHandler.XMLInterpreterBase.Data.EnumEntry:DiagnosisOptions；1；OPTION_SAVE_TO_LOG
P0.5261800.0.0；Festo.Tool.XMLHandler.XMLInterpreterBase.Data.EnumEntry:DiagnosisLevel；256；DIAGNOSIS_LEVEL_STOP_CATEGORY_1
P0.5261801.0.0；Festo.Tool.XMLHandler.XMLInterpreterBase.Data.EnumEntry:DiagnosisOptions；1；OPTION_SAVE_TO_LOG
P0.11280051.0.0；System.Boolean；True；True
P0.11280201.0.0；Festo.Tool.XMLHandler.XMLInterpreterBase.Data.EnumEntry:PDTelegram；111；PDTelegram_111
P0.11280202.0.0；Festo.Tool.XMLHandler.XMLInterpreterBase.Data.EnumEntry:DiagnosisLevel；16；DIAGNOSIS_LEVEL_WARNING
P0.11280203.0.0；Festo.Tool.XMLHandler.XMLInterpreterBase.Data.EnumEntry:DiagnosisOptions；1；OPTION_SAVE_TO_LOG
P0.11280204.0.0；Festo.Tool.XMLHandler.XMLInterpreterBase.Data.EnumEntry:PDTelegram；65534；PDTelegram_None
P0.11290101.0.0；Festo.Tool.XMLHandler.XMLInterpreterBase.Data.EnumEntry:DiagnosisLevel；256；DIAGNOSIS_LEVEL_STOP_CATEGORY_1
P0.12591906.0.0；Festo.Tool.XMLHandler.XMLInterpreterBase.Data.EnumEntry:DiagnosisOptions；1；OPTION_SAVE_TO_LOG
P1.11.0.0；System.Int32；0x00000000；0
P1.14.0.0；System.Boolean；True；True
P1.18.0.0；Festo.Tool.XMLHandler.XMLInterpreterBase.Data.EnumEntry:DiagnosisOptions；1；OPTION_SAVE_TO_LOG
P1.22.0.0；System.Single；0x00000000；0.00
P1.23.0.0；System.Single；0x00000000；0.00
P1.27.0.0；System.Boolean；False；False
P1.28.0.0；System.Boolean；False；False
P1.29.0.0；Festo.Tool.XMLHandler.XMLInterpreterBase.Data.EnumEntry:BMSelector；0；BM_BRAKE_ONE
P1.40.0.0；System.Single；0x44FA0000；2000.00
P1.40.0.1；System.Single；0x44FA0000；2000.00
P1.40.0.2；System.Single；0x44FA0000；2000.00
P1.43.0.0；Festo.Tool.XMLHandler.XMLInterpreterBase.Data.EnumEntry:MocSt；3；MOC_ST_Cascade
P1.45.0.0；Festo.Tool.XMLHandler.XMLInterpreterBase.Data.EnumEntry:DiagnosisLevel；16；DIAGNOSIS_LEVEL_WARNING
P1.46.0.0；Festo.Tool.XMLHandler.XMLInterpreterBase.Data.EnumEntry:DiagnosisOptions；1；OPTION_SAVE_TO_LOG
P1.47.0.0；Festo.Tool.XMLHandler.XMLInterpreterBase.Data.EnumEntry:DiagnosisLevel；256；DIAGNOSIS_LEVEL_STOP_CATEGORY_1
P1.48.0.0；Festo.Tool.XMLHandler.XMLInterpreterBase.Data.EnumEntry:DiagnosisOptions；1；OPTION_SAVE_TO_LOG
P1.49.0.0；System.Single；0x41200000；10.00
P1.49.0.1；System.Single；0x41200000；10.00
P1.49.0.2；System.Single；0x41200000；10.00
P1.51.0.0；System.Boolean；False；False
P1.51.0.1；System.Boolean；False；False
P1.51.0.2；System.Boolean；False；False
P1.53.0.0；Festo.Tool.XMLHandler.XMLInterpreterBase.Data.EnumEntry:DiagnosisLevel；64；DIAGNOSIS_LEVEL_STOP_CATEGORY_2
P1.80.0.0；System.Single；0x41400D6A；12.00327
P1.81.0.0；System.Single；0x45F7DC0D；7931.506
P1.82.0.0；System.Single；0x41400D6A；12.00327
P1.83.0.0；System.Single；0x45F7DC0D；7931.506
P1.106.0.0；Festo.Tool.XMLHandler.XMLInterpreterBase.Data.EnumEntry:FineInterpolationMode；1；FIPO_MODE_LINEAR
P1.120.0.0；System.UInt32；0x00000000；0
P1.121.0.0；System.UInt32；0x00000001；1
P1.122.0.0；Festo.Tool.XMLHandler.XMLInterpreterBase.Data.EnumEntry:AmSources；0；AmPrimaryEncoder
P1.123.0.0；Festo.Tool.XMLHandler.XMLInterpreterBase.Data.EnumEntry:AmSources；1；AmSecondaryEncoder
P1.124.0.0；Festo.Tool.XMLHandler.XMLInterpreterBase.Data.EnumEntry:AmSources；0；AmPrimaryEncoder
P1.125.0.0；Festo.Tool.XMLHandler.XMLInterpreterBase.Data.EnumEntry:AmSources；1；AmSecondaryEncoder
P1.126.0.0；Festo.Tool.XMLHandler.XMLInterpreterBase.Data.EnumEntry:AmSources；0；AmPrimaryEncoder
P1.127.0.0；Festo.Tool.XMLHandler.XMLInterpreterBase.Data.EnumEntry:AmSources；0；AmPrimaryEncoder
P1.139.0.0；Festo.Tool.XMLHandler.XMLInterpreterBase.Data.EnumEntry:DiagnosisOptions；1；OPTION_SAVE_TO_LOG
P1.143.0.0；Festo.Tool.XMLHandler.XMLInterpreterBase.Data.EnumEntry:DiagnosisLevel；256；DIAGNOSIS_LEVEL_STOP_CATEGORY_1
P1.201.0.0；System.Single；0x3F800000；1.00
P1.202.0.0；System.Single；0x00000000；0.00
P1.220.0.0；System.Single；0x3FC20811；1.515871
P1.221.0.0；System.Int64；0x0000000000000000；0.00
P1.222.0.0；System.Single；0xBDCCCCCD；-0.10
P1.223.0.0；System.Single；0x3DCCCCCD；0.10
P1.224.0.0；System.Single；0x3C4FA3D0；0.01267333
P1.225.0.0；System.Single；0x3F01EE4C；0.5075424
P1.226.0.0；System.Single；0x00000000；0.00
P1.226.0.1；System.Single；0x00000000；0.00
P1.226.0.2；System.Single；0x00000000；0.00
P1.238.0.0；Festo.Tool.XMLHandler.XMLInterpreterBase.Data.EnumEntry:DiagnosisLevel；4096；DIAGNOSIS_LEVEL_STOP_CATEGORY_0
P1.239.0.0；Festo.Tool.XMLHandler.XMLInterpreterBase.Data.EnumEntry:DiagnosisOptions；1；OPTION_SAVE_TO_LOG
P1.270.0.0；System.Single；0x40A00000；5.00
P1.284.0.0；Festo.Tool.XMLHandler.XMLInterpreterBase.Data.EnumEntry:PowerstageType；1；ptStepper
P1.287.0.0；System.Single；0x41900000；18.00
P1.288.0.0；System.Single；0x41F00000；30.00
P1.372.0.0；System.Single；0x40A00000；5.00
P1.373.0.0；System.Single；0x42C80000；100.00
P1.374.0.0；System.Single；0x42480000；50.00
P1.390.0.0；System.Single；0x3DCCCCCD；0.10
P1.391.0.0；System.Single；0x3E4CCCCD；0.20
P1.395.0.0；Festo.Tool.XMLHandler.XMLInterpreterBase.Data.EnumEntry:DiagnosisLevel；4096；DIAGNOSIS_LEVEL_STOP_CATEGORY_0
P1.396.0.0；Festo.Tool.XMLHandler.XMLInterpreterBase.Data.EnumEntry:DiagnosisOptions；1；OPTION_SAVE_TO_LOG
P1.397.0.0；Festo.Tool.XMLHandler.XMLInterpreterBase.Data.EnumEntry:DiagnosisLevel；4096；DIAGNOSIS_LEVEL_STOP_CATEGORY_0
P1.398.0.0；Festo.Tool.XMLHandler.XMLInterpreterBase.Data.EnumEntry:DiagnosisOptions；1；OPTION_SAVE_TO_LOG
P1.399.0.0；Festo.Tool.XMLHandler.XMLInterpreterBase.Data.EnumEntry:DiagnosisLevel；4096；DIAGNOSIS_LEVEL_STOP_CATEGORY_0
P1.430.0.0；System.Single；0x3BA3D70A；0.005
P1.434.0.0；Festo.Tool.XMLHandler.XMLInterpreterBase.Data.EnumEntry:DiagnosisLevel；256；DIAGNOSIS_LEVEL_STOP_CATEGORY_1
P1.435.0.0；Festo.Tool.XMLHandler.XMLInterpreterBase.Data.EnumEntry:DiagnosisOptions；1；OPTION_SAVE_TO_LOG
P1.436.0.0；System.Boolean；False；False
P1.437.0.0；System.Single；0x3E4CCCCD；0.20
P1.438.0.0；Festo.Tool.XMLHandler.XMLInterpreterBase.Data.EnumEntry:DiagnosisLevel；256；DIAGNOSIS_LEVEL_STOP_CATEGORY_1
P1.439.0.0；Festo.Tool.XMLHandler.XMLInterpreterBase.Data.EnumEntry:DiagnosisOptions；1；OPTION_SAVE_TO_LOG
P1.462.0.0；System.Single；0x3DCCCCCD；0.10
P1.463.0.0；System.Single；0x3C23D70A；0.01
P1.464.0.0；System.Single；0x3D4CCCCD；0.05
P1.465.0.0；System.Single；0x3D4CCCCD；0.05
P1.466.0.0；System.Single；0x3CF5C28F；0.03
P1.467.0.0；System.Single；0x3C03126F；0.008
P1.468.0.0；System.Single；0x3D4CCCCD；0.05
P1.469.0.0；System.Single；0x3A1D4952；0.0006
P1.627.0.0；Festo.Tool.XMLHandler.XMLInterpreterBase.Data.EnumEntry:DiagnosisLevel；256；DIAGNOSIS_LEVEL_STOP_CATEGORY_1
P1.628.0.0；Festo.Tool.XMLHandler.XMLInterpreterBase.Data.EnumEntry:DiagnosisOptions；1；OPTION_SAVE_TO_LOG
P1.631.0.0；System.Single；0x3EA8F5C3；0.33
P1.635.0.0；System.Single；0x3F333333；0.70
P1.636.0.0；System.Single；0x44098000；550.00
P1.637.0.0；System.Single；0x00000000；0.00
P1.662.0.0；System.Single；0x3DCCCCCD；0.10
P1.664.0.0；System.Single；0x43B40000；360.00
P1.665.0.0；Festo.Tool.XMLHandler.XMLInterpreterBase.Data.EnumEntry:ZADAlgorithm；1；ZAD_ADVANCED
P1.668.0.0；Festo.Tool.XMLHandler.XMLInterpreterBase.Data.EnumEntry:ZADMode；1；ZAD_AUTOMATIC
P1.669.0.0；System.Single；0x3D4CCCCD；0.05
P1.718.0.0；System.UInt32；0x00000032；50
P1.819.0.0；System.Boolean；True；True
P1.821.0.0；Festo.Tool.XMLHandler.XMLInterpreterBase.Data.EnumEntry:DiagnosisLevel；4；DIAGNOSIS_LEVEL_INFO
P1.822.0.0；Festo.Tool.XMLHandler.XMLInterpreterBase.Data.EnumEntry:DiagnosisOptions；0；OPTION_NONE
P1.841.0.0；System.Boolean；True；True
P1.842.0.0；System.Single；0x42700000；60.00
P1.843.0.0；System.Single；0x3C23D70A；0.01
P1.844.0.0；System.Single；0x3F800000；1.00
P1.845.0.0；System.Single；0x42C80000；100.00
P1.846.0.0；System.Single；0x3BA3D70A；0.005
P1.847.0.0；System.Single；0x3F800000；1.00
P1.848.0.0；System.Single；0x42C80000；100.00
P1.849.0.0；System.Single；0x3D4CCCCD；0.05
P1.850.0.0；System.Single；0xC003D7CB；-2.060046
P1.851.0.0；System.Single；0x4003D7CB；2.060046
P1.852.0.0；System.Single；0xBFB33333；-1.40
P1.853.0.0；System.Single；0x3FB33333；1.40
P1.854.0.0；System.Single；0xC0A00000；-5.00
P1.855.0.0；System.Single；0x40A00000；5.00
P1.856.0.0；System.Single；0x40A00000；5.00
P1.910.0.0；Festo.Tool.XMLHandler.XMLInterpreterBase.Data.EnumEntry:MocOp；0；MOC_OP_Off
P1.954.0.0；Festo.Tool.XMLHandler.XMLInterpreterBase.Data.EnumEntry:DiagnosisLevel；4096；DIAGNOSIS_LEVEL_STOP_CATEGORY_0
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
P1.1817.0.118；System.Int64；0x0000000000000000；0
P1.1817.0.119；System.Int64；0x0000000000000000；0
P1.1817.0.120；System.Int64；0x0000000000000000；0
P1.1817.0.121；System.Int64；0x0000000000000000；0
P1.1817.0.122；System.Int64；0x0000000000000000；0
P1.1817.0.123；System.Int64；0x0000000000000000；0
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
