Ratikantamishranordhausen/MectoSYS/01_Mechanical_Design/01_CAD Design/3D file/07_Comp/led-stack-light-indicator-signal-1.snapshot.3/Stack Light/Assembly Light Stack.stp

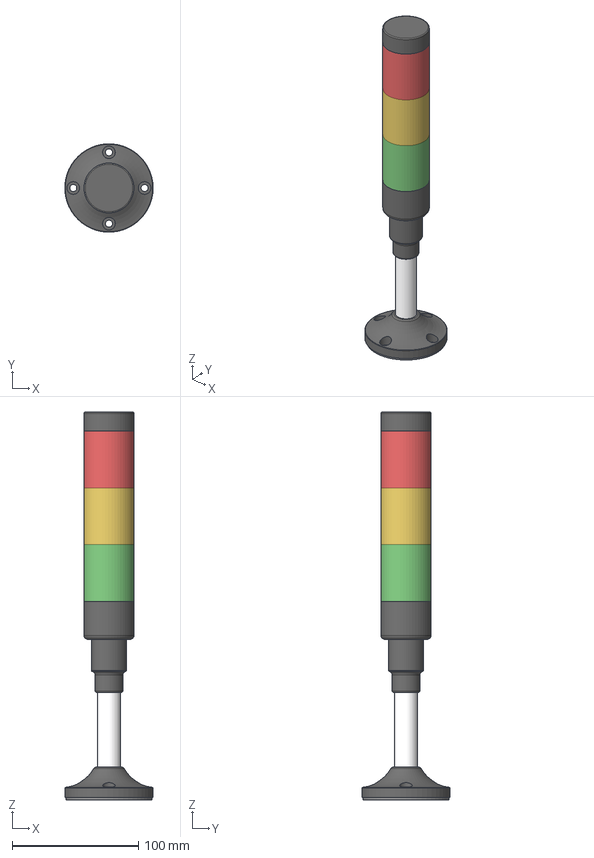
[picture p24: CAD file, 2026-05-26]
01_Mechanical_Design/01_CAD Design/3D file/07_Comp/led-stack-light-indicator-signal-1.snapshot.3/Stack Light/Assembly Light Stack.stp
69.9 x 70.0 x 307.2 mm
Light Stack
Connecting Rod
Base
Black Rubber Pad Bottom
