Ratikantamishranordhausen/MectoSYS/01_Mechanical_Design/01_CAD Design/3D file/03_Conveyor Assembly/18_Motor controller/2ph63091a-2-channel-5v-relay-module-1.snapshot.2/2PH63091A Parts/Relay - 2 Channel - 2PH63091A - Montaj.SLDASM

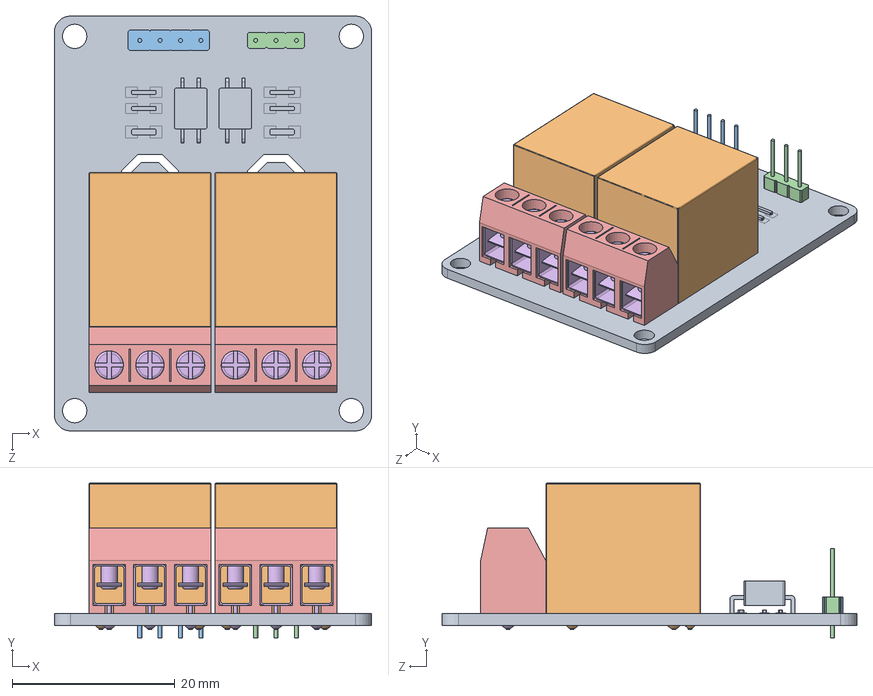
[picture p25: CAD file, 2026-05-26]
01_Mechanical_Design/01_CAD Design/3D file/03_Conveyor Assembly/18_Motor controller/2ph63091a-2-channel-5v-relay-module-1.snapshot.2/2PH63091A Parts/Relay - 2 Channel - 2PH63091A - Montaj.SLDASM
39.0 x 19.0 x 51.0 mm
2PH63091A Board
Relay Body x 2
4 Headers
Headers
Clamp Body x 2
Metal Clamp Part x 6
