Ratikantamishranordhausen/MectoSYS/01_Mechanical_Design/01_CAD Design/3D file/01_Station Table/04_CBM6-12_STEP_AP214_20260415/CBM6-12.stp

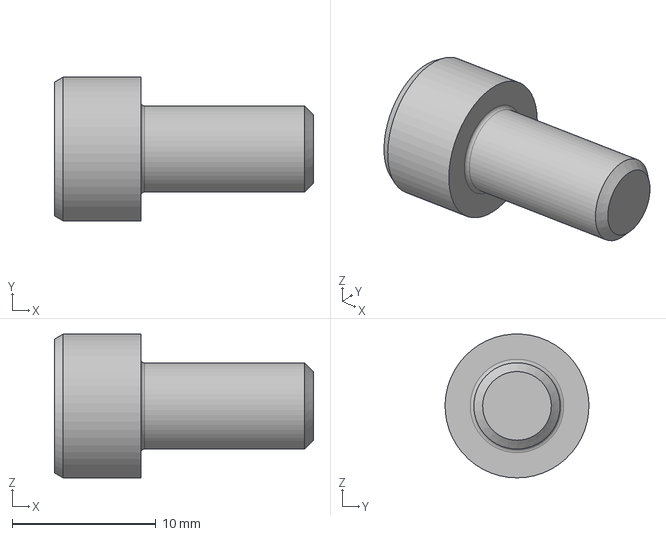
[picture p26: CAD file, 2026-05-26]
01_Mechanical_Design/01_CAD Design/3D file/01_Station Table/04_CBM6-12_STEP_AP214_20260415/CBM6-12.stp
18.0 x 10.00 x 9.99 mm
