Ratikantamishranordhausen/MectoSYS/01_Mechanical_Design/01_CAD Design/3D file/01_Station Table/06_HFPD6-3030_STEP_AP214_20260415/HFPD6-3030.stp

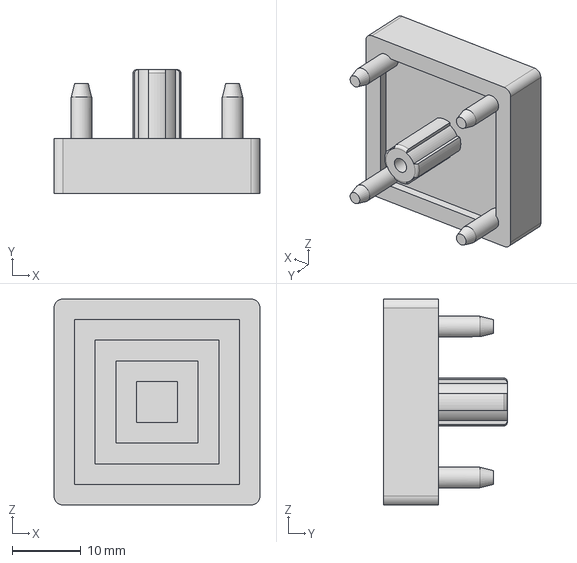
[picture p27: CAD file, 2026-05-26]
01_Mechanical_Design/01_CAD Design/3D file/01_Station Table/06_HFPD6-3030_STEP_AP214_20260415/HFPD6-3030.stp
30.0 x 18.0 x 30.0 mm
