Ratikantamishranordhausen/MectoSYS/01_Mechanical_Design/01_CAD Design/3D file/02_Slider/08_HFSPURE6-1220-2500_STEP_AP214_20260415/HFSPURE6-1220-2500.stp

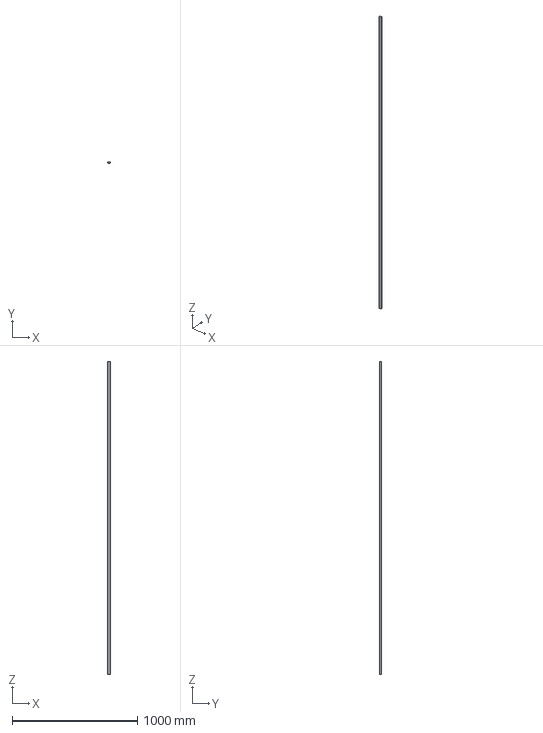
[picture p28: CAD file, 2026-05-26]
01_Mechanical_Design/01_CAD Design/3D file/02_Slider/08_HFSPURE6-1220-2500_STEP_AP214_20260415/HFSPURE6-1220-2500.stp
20.0 x 12.0 x 2500.0 mm
