Ratikantamishranordhausen/MectoSYS/01_Mechanical_Design/01_CAD Design/3D file/02_Slider/09_HFSFIN6-1554-1000_STEP_AP214_20260415/HFSFIN6-1554-1000.stp

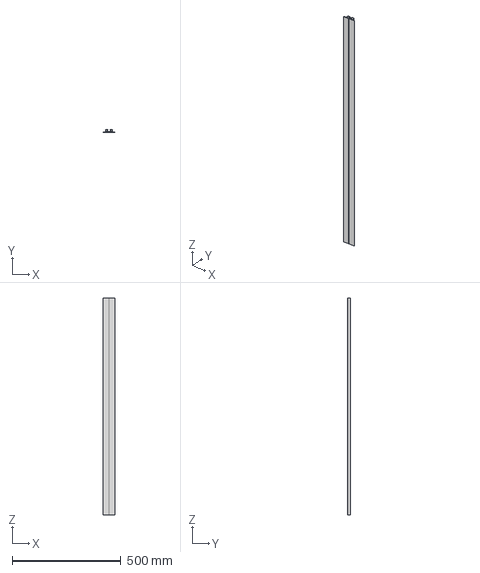
[picture p29: CAD file, 2026-05-26]
01_Mechanical_Design/01_CAD Design/3D file/02_Slider/09_HFSFIN6-1554-1000_STEP_AP214_20260415/HFSFIN6-1554-1000.stp
54.0 x 15.0 x 1000.0 mm
