Ratikantamishranordhausen/MectoSYS/01_Mechanical_Design/01_CAD Design/3D file/02_Slider/11_HFCL5-2040-B_STEP_AP214_20260416/HFCL5-2040-B.stp

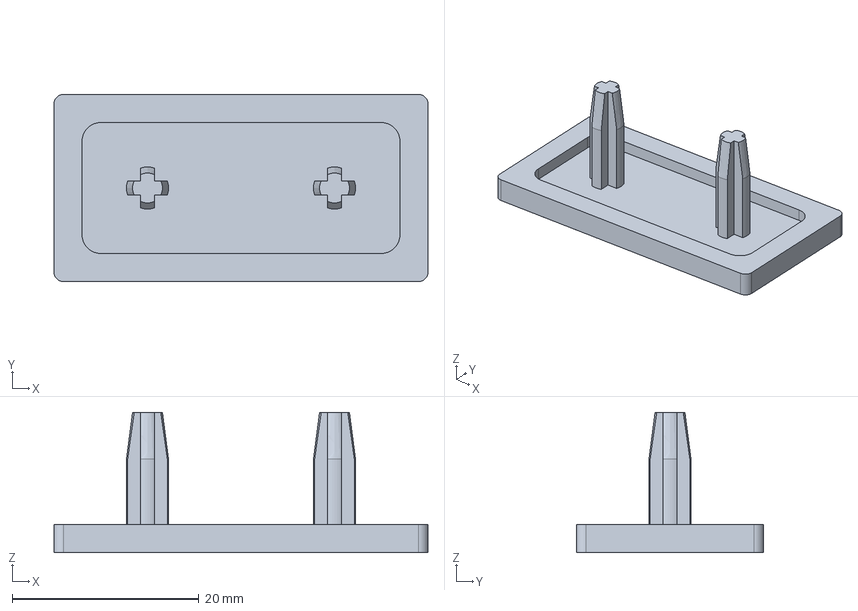
[picture p30: CAD file, 2026-05-26]
01_Mechanical_Design/01_CAD Design/3D file/02_Slider/11_HFCL5-2040-B_STEP_AP214_20260416/HFCL5-2040-B.stp
40.0 x 20.0 x 15.0 mm
