Ratikantamishranordhausen/MectoSYS/01_Mechanical_Design/01_CAD Design/3D file/03_Conveyor Assembly/Conveyor 2.0/06_Side holding bracket.stl

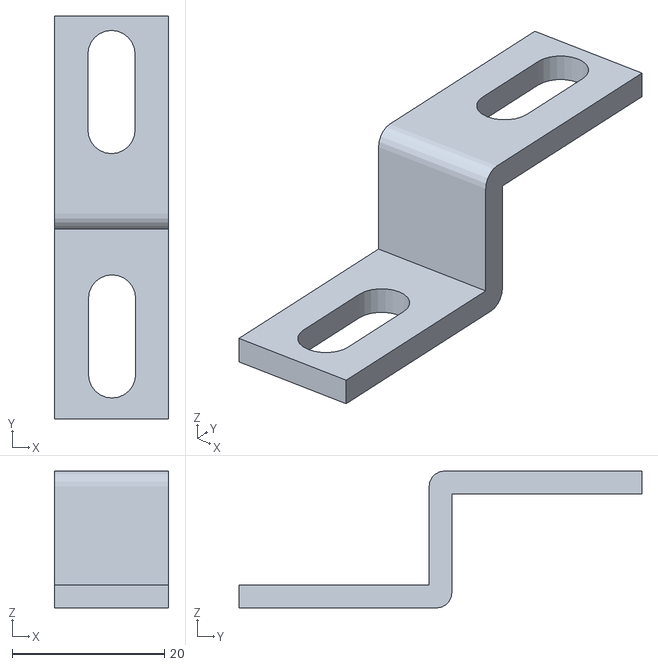
[picture p32: CAD file, 2026-07-16]
01_Mechanical_Design/01_CAD Design/3D file/03_Conveyor Assembly/Conveyor 2.0/06_Side holding bracket.stl
15.0 x 53.0 x 18.0
