Ratikantamishranordhausen/MectoSYS/01_Mechanical_Design/01_CAD Design/3D file/06_Handlling Station/cable-drag-chain-10x20mm-1.snapshot.1/Drag Chain 10x20.stp

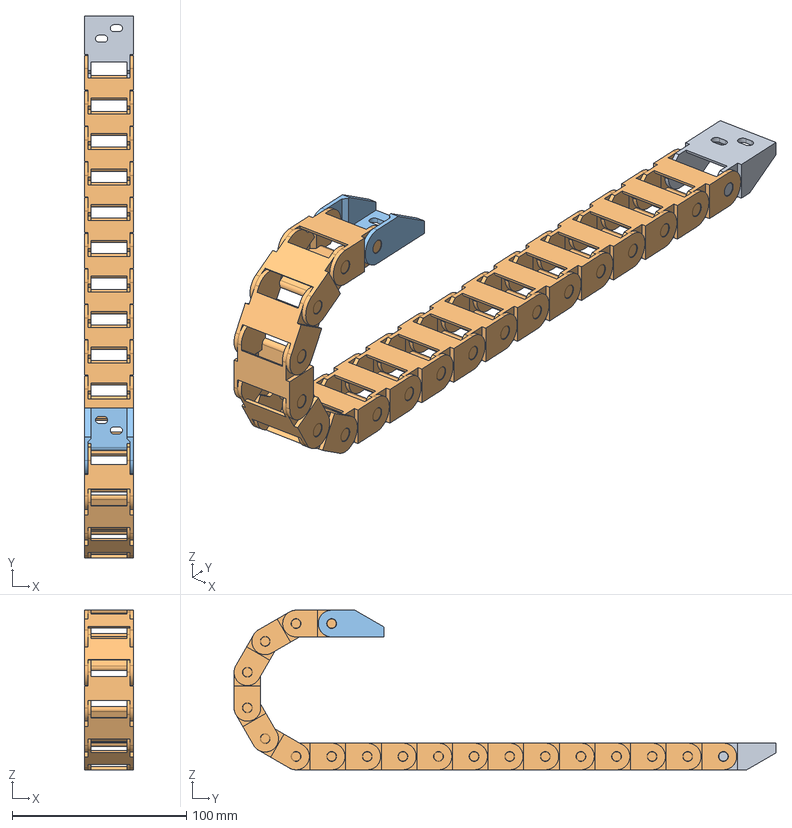
[picture p33: CAD file, 2026-05-26]
01_Mechanical_Design/01_CAD Design/3D file/06_Handlling Station/cable-drag-chain-10x20mm-1.snapshot.1/Drag Chain 10x20.stp
27.8 x 310.8 x 91.6 mm
Bloc 03
Bloc 01 x 18
Bloc 02
