Ratikantamishranordhausen/MectoSYS/01_Mechanical_Design/01_CAD Design/3D file/Mounting_Kit/Coupling.stl

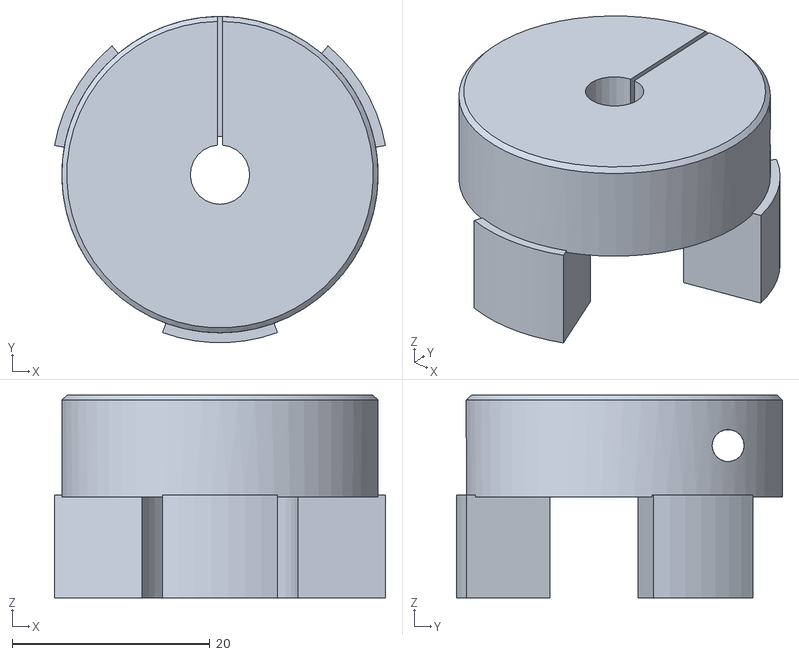
[picture p34: CAD file, 2026-06-02]
01_Mechanical_Design/01_CAD Design/3D file/Mounting_Kit/Coupling.stl
33.5 x 33.0 x 20.5
