Ratikantamishranordhausen/MectoSYS/01_Mechanical_Design/01_CAD Design/3D file/Mounting_Kit/Mounting Bracket.stl

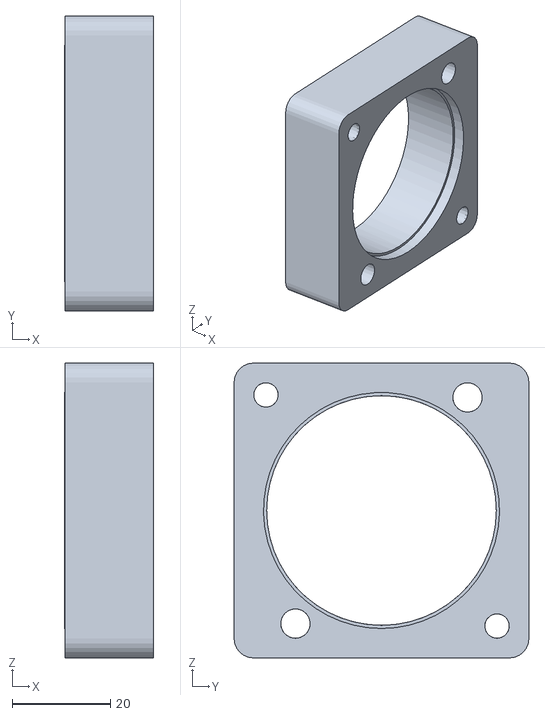
[picture p36: CAD file, 2026-06-02]
01_Mechanical_Design/01_CAD Design/3D file/Mounting_Kit/Mounting Bracket.stl
18.1 x 60.0 x 60.0
