Ratikantamishranordhausen/MectoSYS/01_Mechanical_Design/01_CAD Design/3D file/03_Conveyor Assembly/18_Motor controller/2ph63091a-2-channel-5v-relay-module-1.snapshot.2/2PH63091A Parts/Relay Body.SLDPRT

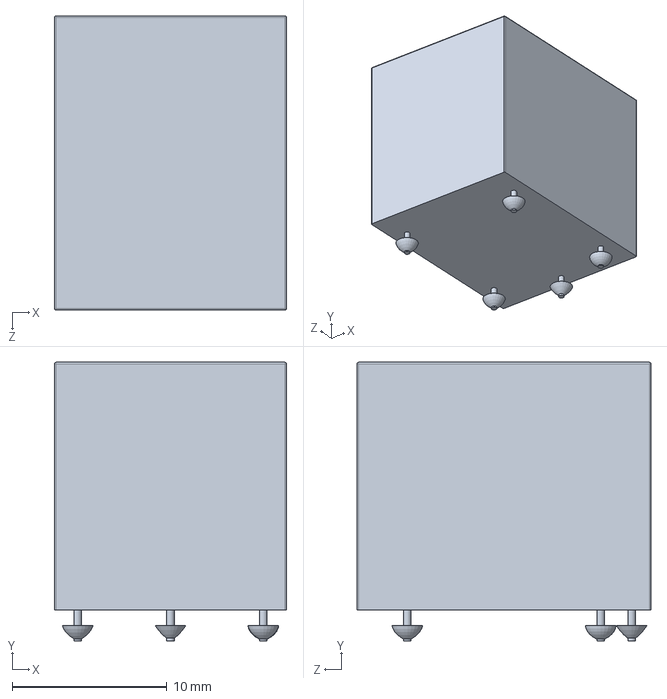
[picture p37: CAD file, 2026-05-26]
01_Mechanical_Design/01_CAD Design/3D file/03_Conveyor Assembly/18_Motor controller/2ph63091a-2-channel-5v-relay-module-1.snapshot.2/2PH63091A Parts/Relay Body.SLDPRT
15.0 x 18.0 x 19.0 mm
