Ratikantamishranordhausen/MectoSYS/01_Mechanical_Design/01_CAD Design/3D file/Mounting_Kit/coupling_conn.stl

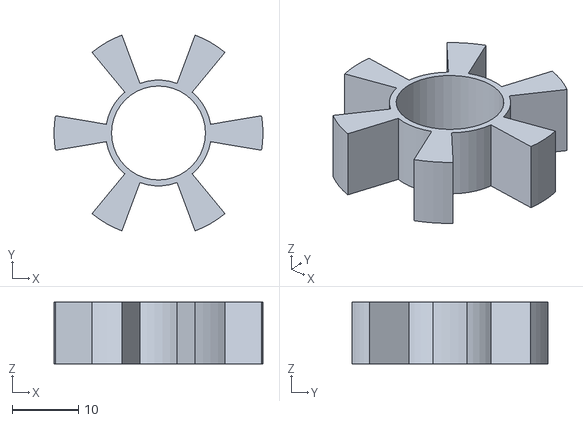
[picture p38: CAD file, 2026-06-02]
01_Mechanical_Design/01_CAD Design/3D file/Mounting_Kit/coupling_conn.stl
31.6 x 29.6 x 9.30
