Ratikantamishranordhausen/MectoSYS/01_Mechanical_Design/01_CAD Design/3D file/03_Conveyor Assembly/18_Motor controller/2ph63091a-2-channel-5v-relay-module-1.snapshot.2/2PH63091A Parts/Headers.SLDPRT

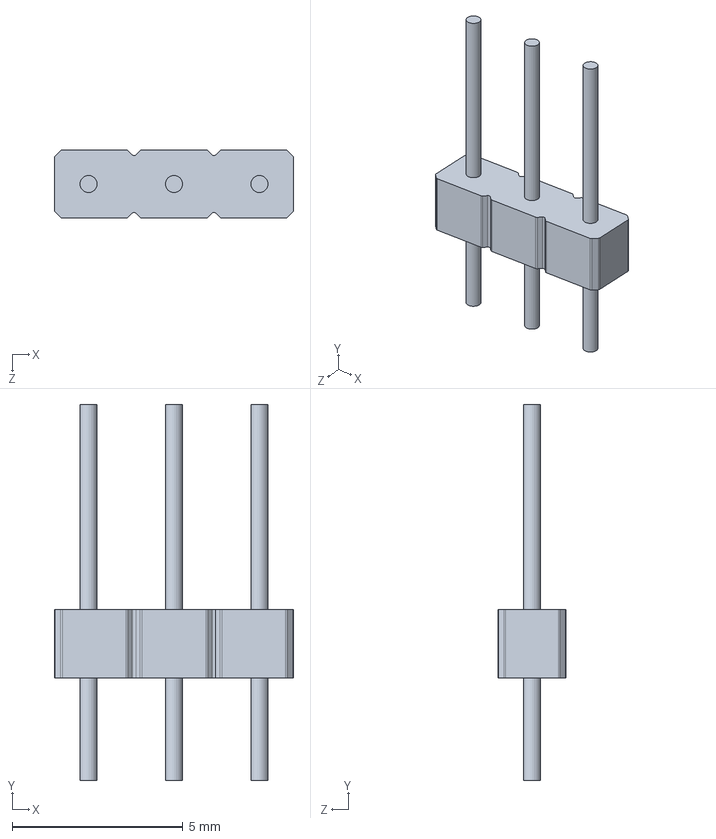
[picture p39: CAD file, 2026-05-26]
01_Mechanical_Design/01_CAD Design/3D file/03_Conveyor Assembly/18_Motor controller/2ph63091a-2-channel-5v-relay-module-1.snapshot.2/2PH63091A Parts/Headers.SLDPRT
7.00 x 11.0 x 2.00 mm
