Ratikantamishranordhausen/MectoSYS/(list of files, cad)

Other CAD files:
01_Mechanical_Design/01_CAD Design/2D File/Mectosys_Layout.dwg
01_Mechanical_Design/01_CAD Design/2D File/Layout.dwg
01_Mechanical_Design/01_CAD Design/2D File/OldVersions/Layout.0002.dwg
01_Mechanical_Design/01_CAD Design/3D file/01_Station Table/01_EFSP6-30030-900_Inventor/EFSP6-30030-900.ipt
01_Mechanical_Design/01_CAD Design/3D file/01_Station Table/01_EFSP6-30030-900_Inventor/OldVersions/EFSP6-30030-900.0002.ipt
01_Mechanical_Design/01_CAD Design/3D file/01_Station Table/02_HFS6-3030-2400_Inventor/HFS6-3030-2400.ipt
01_Mechanical_Design/01_CAD Design/3D file/01_Station Table/02_HFS6-3030-2400_Inventor/HFS6-3030-540.ipt
01_Mechanical_Design/01_CAD Design/3D file/01_Station Table/02_HFS6-3030-2400_Inventor/HFS6-3030-800.ipt
01_Mechanical_Design/01_CAD Design/3D file/01_Station Table/02_HFS6-3030-2400_Inventor/HFS6-3030-840.ipt
01_Mechanical_Design/01_CAD Design/3D file/01_Station Table/02_HFS6-3030-2400_Inventor/OldVersions/HFS6-3030-540.0001.ipt
01_Mechanical_Design/01_CAD Design/3D file/01_Station Table/02_HFS6-3030-2400_Inventor/OldVersions/HFS6-3030-840.0001.ipt
01_Mechanical_Design/01_CAD Design/3D file/01_Station Table/03_CHBLFSN6_Inventor/BRACKET_CHBLFSN6.ipt
01_Mechanical_Design/01_CAD Design/3D file/01_Station Table/03_CHBLFSN6_Inventor/CHBLFSN6.iam
01_Mechanical_Design/01_CAD Design/3D file/01_Station Table/04_CBM6-12_STEP_AP214_20260415/CBM6-12/CBM6-12.ipt
01_Mechanical_Design/01_CAD Design/3D file/01_Station Table/06_HFPD6-3030_STEP_AP214_20260415/HFPD6-3030/HFPD6-3030.ipt
01_Mechanical_Design/01_CAD Design/3D file/01_Station Table/07_HFC6-3090-B_Inventor/HFC6-3090-B.ipt
01_Mechanical_Design/01_CAD Design/3D file/02_Slider/08_HFSPURE6-1220-2500_STEP_AP214_20260415/HFSPURE6-1220-2500/HFSPURE6-1220-2500.ipt
01_Mechanical_Design/01_CAD Design/3D file/02_Slider/08_HFSPURE6-1220-2500_STEP_AP214_20260415/HFSPURE6-1220-2500/HFSPURE6-1220-2500_MIR.ipt
01_Mechanical_Design/01_CAD Design/3D file/02_Slider/08_HFSPURE6-1220-2500_STEP_AP214_20260415/HFSPURE6-1220-2500/OldVersions/HFSPURE6-1220-2500.0001.ipt
01_Mechanical_Design/01_CAD Design/3D file/02_Slider/09_HFSFIN6-1554-1000_STEP_AP214_20260415/HFSFIN6-1554-1000/HFSFIN6-1554-1000.ipt
01_Mechanical_Design/01_CAD Design/3D file/02_Slider/10_HFS5-2040-1500_Inventor/HFS5-2040-1500.ipt
01_Mechanical_Design/01_CAD Design/3D file/02_Slider/10_HFS5-2040-1500_Inventor/OldVersions/HFS5-2040-1500.0001.ipt
01_Mechanical_Design/01_CAD Design/3D file/02_Slider/11_HFCL5-2040-B_STEP_AP214_20260416/HFCL5-2040-B/HFCL5-2040-B.ipt
01_Mechanical_Design/01_CAD Design/3D file/02_Slider/14_Slider Holding Bracket/OldVersions/Slider Holding Bracket.0002.ipt
01_Mechanical_Design/01_CAD Design/3D file/02_Slider/14_Slider Holding Bracket/Slider Holding Bracket.ipt
01_Mechanical_Design/01_CAD Design/3D file/02_Slider/15_Side bar holding bracket/OldVersions/Side bar holding bracket.0001.ipt
01_Mechanical_Design/01_CAD Design/3D file/02_Slider/15_Side bar holding bracket/Side bar holding bracket.ipt
01_Mechanical_Design/01_CAD Design/3D file/02_Slider/OldVersions/end plate.0001.ipt
01_Mechanical_Design/01_CAD Design/3D file/02_Slider/end plate.ipt
01_Mechanical_Design/01_CAD Design/3D file/03_Conveyor Assembly/17_Stainless Steel Mini Conveyor, DC 12 V/Stainless Steel Mini Conveyor, DC 12 V.ipt
01_Mechanical_Design/01_CAD Design/3D file/03_Conveyor Assembly/18_Motor controller/2ph63091a-2-channel-5v-relay-module-1.snapshot.2/2PH63091A Pa.ipt
01_Mechanical_Design/01_CAD Design/3D file/03_Conveyor Assembly/19_Conveyor mounting bracket/Conveyor mounting bracket.ipt
01_Mechanical_Design/01_CAD Design/3D file/03_Conveyor Assembly/19_Conveyor mounting bracket/OldVersions/Conveyor mounting bracket.0001.ipt
01_Mechanical_Design/01_CAD Design/3D file/03_Conveyor Assembly/22_181857353-9-0807012/0807012.ipt
01_Mechanical_Design/01_CAD Design/3D file/03_Conveyor Assembly/23_181857052-9-2903801/2903801.ipt
01_Mechanical_Design/01_CAD Design/3D file/03_Conveyor Assembly/Conveyor 2.0/Conveyor Assembly.iam
01_Mechanical_Design/01_CAD Design/3D file/03_Conveyor Assembly/Conveyor 2.0/Mounting Bracket.ipt
01_Mechanical_Design/01_CAD Design/3D file/03_Conveyor Assembly/Conveyor 2.0/OldVersions/Mounting Bracket.0001.ipt
01_Mechanical_Design/01_CAD Design/3D file/03_Conveyor Assembly/Conveyor 2.0/Side holding bracket.ipt
01_Mechanical_Design/01_CAD Design/3D file/03_Conveyor Assembly/Conveyor 2.0/roller bracket.ipt
01_Mechanical_Design/01_CAD Design/3D file/03_Conveyor Assembly/Conveyor 2.0/roller.ipt
01_Mechanical_Design/01_CAD Design/3D file/04_Distribution module/35_PARTserver0202604161719057653412610e898ce/AIS2024/19182 DSNU-8-100-P---(A----0-ZR).ipt
01_Mechanical_Design/01_CAD Design/3D file/04_Distribution module/35_PARTserver0202604161719057653412610e898ce/AIS2024/19182 DSNU-8-100-P---(A---00--0-KS).ipt
01_Mechanical_Design/01_CAD Design/3D file/04_Distribution module/35_PARTserver0202604161719057653412610e898ce/AIS2024/19182 DSNU-8-100-P-A---(0).iam
01_Mechanical_Design/01_CAD Design/3D file/04_Distribution module/35_PARTserver0202604161719057653412610e898ce/AIS2024/DIN-439-B - M12x1_25(F).ipt
01_Mechanical_Design/01_CAD Design/3D file/04_Distribution module/36_PARTserver0202604161723152183443510e898ce/AIS2024/1247168 ASCF-M-23-S DM 2_1-3_4.ipt
01_Mechanical_Design/01_CAD Design/3D file/04_Distribution module/36_PARTserver0202604161723152183443510e898ce/AIS2024/574333 SMT-8M-A-1---OE---(part).ipt
01_Mechanical_Design/01_CAD Design/3D file/04_Distribution module/36_PARTserver0202604161723152183443510e898ce/AIS2024/574335 SMT-8M-A-PS-24V-E-2,5-OE.iam
01_Mechanical_Design/01_CAD Design/3D file/04_Distribution module/37_PARTserver0202604161726300103468710e898ce/175091 SMBR-8-8.ipt
01_Mechanical_Design/01_CAD Design/3D file/04_Distribution module/38_PARTserver0202604161737460883546210e898ce/193138 GRLA-M5-QS-4-D.ipt
01_Mechanical_Design/01_CAD Design/3D file/04_Distribution module/39_PARTserver0202604161741082463571310e898ce/153304 QSM-M5-4.ipt
01_Mechanical_Design/01_CAD Design/3D file/04_Distribution module/40_PARTserver0202604161744284673589710e898ce/AIS2024/564212 VUVG-L-10-M52-M-T-M5--1H2--L-W1---(G).ipt
01_Mechanical_Design/01_CAD Design/3D file/04_Distribution module/40_PARTserver0202604161744284673589710e898ce/AIS2024/566654 NEBV-H1G2-KN-0_5-N-LE2.ipt
01_Mechanical_Design/01_CAD Design/3D file/04_Distribution module/40_PARTserver0202604161744284673589710e898ce/AIS2024/566714 VAVE-L1-1VH2-LP.ipt
01_Mechanical_Design/01_CAD Design/3D file/04_Distribution module/40_PARTserver0202604161744284673589710e898ce/AIS2024/578162 VUVG-L10-M52-MT-M5-1H2L-W1.iam
01_Mechanical_Design/01_CAD Design/3D file/04_Distribution module/41_PARTserver0202604161748310483612910e898ce/1205858 AMTE-M-LH-M5.ipt
01_Mechanical_Design/01_CAD Design/3D file/04_Distribution module/44_Housing/Housing.ipt
01_Mechanical_Design/01_CAD Design/3D file/04_Distribution module/44_Housing/OldVersions/Housing.0004.ipt
01_Mechanical_Design/01_CAD Design/3D file/04_Distribution module/Cylinder assembly/OldVersions/cylinder assembly.0001.iam
01_Mechanical_Design/01_CAD Design/3D file/04_Distribution module/Cylinder assembly/cylinder assembly.iam
01_Mechanical_Design/01_CAD Design/3D file/05_Pick and place/10_HFS5-2040-1500_Inventor/HFS5-2040-1500.ipt
01_Mechanical_Design/01_CAD Design/3D file/05_Pick and place/10_HFS5-2040-1500_Inventor/OldVersions/HFS5-2040-1500.0001.ipt
01_Mechanical_Design/01_CAD Design/3D file/05_Pick and place/Cup holder/AIS2024/130519 ESHM-M14x1.ipt
01_Mechanical_Design/01_CAD Design/3D file/05_Pick and place/Cup holder/AIS2024/189199 ESH-HA-4-QS---(0).iam
01_Mechanical_Design/01_CAD Design/3D file/05_Pick and place/Cup holder/AIS2024/189199 ESH-HA-4-QS.ipt
01_Mechanical_Design/01_CAD Design/3D file/05_Pick and place/Cup/189401 ESS-20-CS.ipt
01_Mechanical_Design/01_CAD Design/3D file/05_Pick and place/Cylinder/AIS2024/4186566 DPDM 16-50---(p).ipt
01_Mechanical_Design/01_CAD Design/3D file/05_Pick and place/Cylinder/AIS2024/4186566 DPDM-Q-50---(h).ipt
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
