Ratikantamishranordhausen/MectoSYS/02_Industrial_OT/01_TIA_Portal/Servo_Drive_Lib_GSDML_Files/Sina_Pos Servo Operation Mode.png

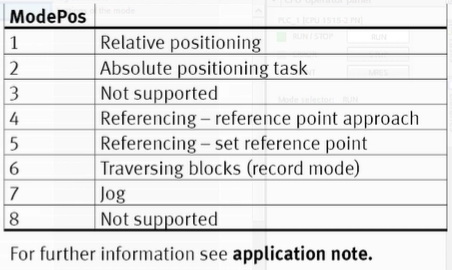
02_Industrial_OT/01_TIA_Portal/Servo_Drive_Lib_GSDML_Files/Sina_Pos Servo Operation Mode.png
