Ratikantamishranordhausen/MectoSYS/01_Mechanical_Design/MectoSYS pneumatic design.pdf

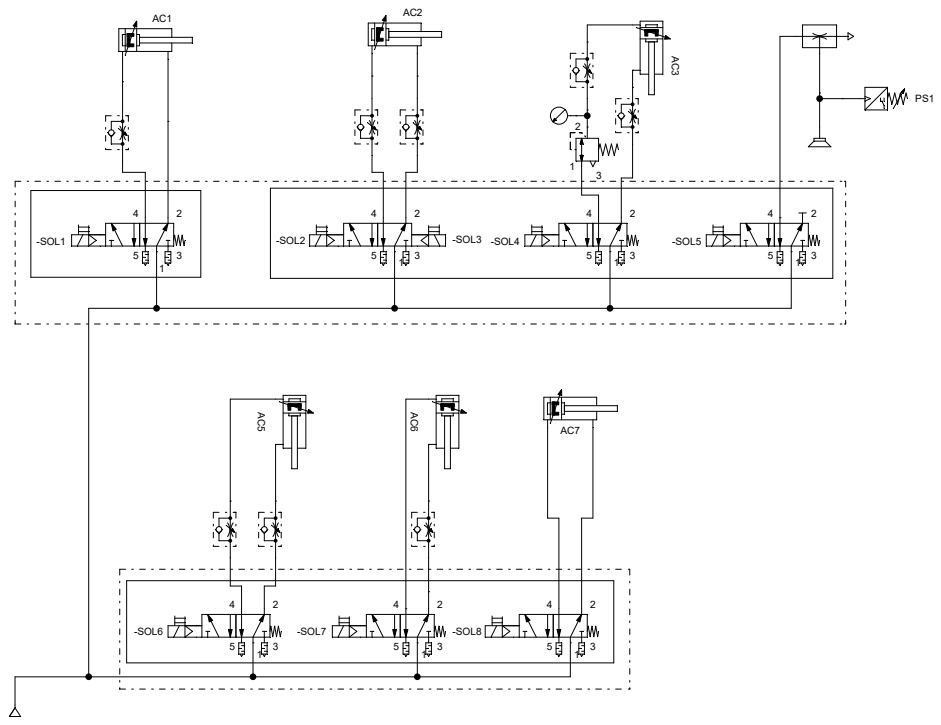
[picture p43: page 1]
-SOL1; -SOL5; -SOL2; -SOL3; -SOL4; -SOL6; -SOL7; -SOL8
