Ratikantamishranordhausen/MectoSYS/(commit log)

2026-05-26 Initial commit: Added mechanical designs,PLC Program, Network Architecture, Material list
    [0807012.ipt, 1205858 AMTE-M-LH-M5.ipt, 1247168 ASCF-M-23-S DM 2_1-3_4.ipt, 130519 ESHM-M14x1.ipt, 1310162 DHRS-25-A---(0).iam, 1310162 DHRS-25-A---(Geh).ipt, 1310162 DHRS-25-A---(Griff).ipt, 1360395 VAME-P11-MK.ipt]
2026-06-02 Mechanical design modified, current mechanical rev is 1
    [Coupling.ipt, Coupling.stl, MectoSYS_Proto_BOM_Rev4.xlsx, MectoSYS_Proto_BOM_Rev5.xlsx, MectoSYS_Rev1.0001.iam, MectoSYS_Rev1.iam, Mounting Bracket.ipt, Mounting Bracket.stl]
2026-07-16 Progress updated images added
    [06_Side holding bracket.stl, Conveyor Assembly.iam, IP Address List Rev0.xlsx, MectoSYS_Proto_BOM_Rev5.xlsx, MectoSYS_Proto_BOM_Rev6.xlsx, MectoSYS_Rev1.0001.iam, MectoSYS_Rev1.0003.iam, MectoSYS_Rev1.iam]
