Ratikantamishranordhausen/MectoSYS/(notices)

Notices in the files:
01_Mechanical_Design/01_CAD Design/3D file/01_Station Table/06_HFPD6-3030_STEP_AP214_20260415/HFPD6-3030.stp:
author */ ('License CC BY-ND 4.0'),
